alidanda93/RoboBeer/CAO_SolidWorks/3167350_Raspberry_Pi_Camera_V2_Case/images/20181021_031637.jpg

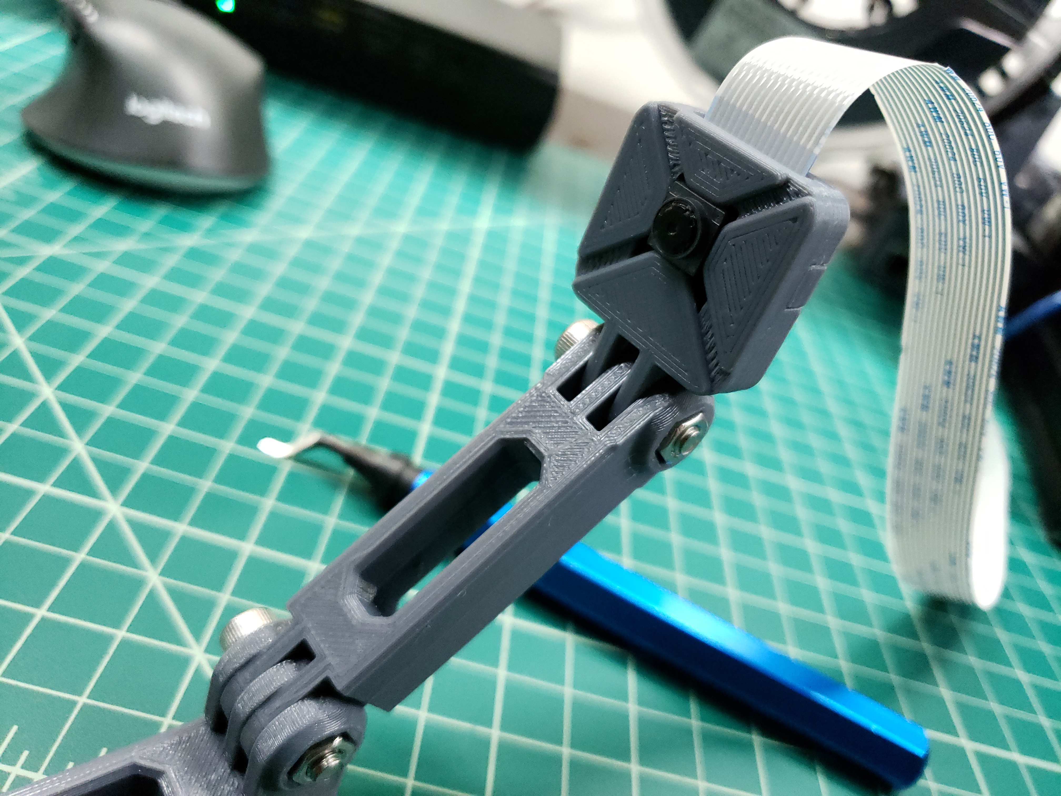
CAO_SolidWorks/3167350_Raspberry_Pi_Camera_V2_Case/images/20181021_031637.jpg
