alidanda93/RoboBeer/README.md

# RoboBeer
Projet de troisième année MSC > ESE
