alidanda93/RoboBeer/STM32/RoboBeer/Doxygene/latex/adc_8c.tex

\hypertarget{adc_8c}{}\doxysection{adc.\+c File Reference}
\label{adc_8c}\index{adc.c@{adc.c}}

This file provides code for the configuration of the ADC instances.  

{\ttfamily \#include \char`\"{}adc.\+h\char`\"{}}\newline
\doxysubsection*{Functions}
\begin{DoxyCompactItemize}
\item 
void \mbox{\hyperlink{adc_8c_acccd58aa70215a6b184ad242312ffd0c}{MX\+\_\+\+ADC1\+\_\+\+Init}} (void)
\item 
void \mbox{\hyperlink{adc_8c_ac3139540667c403c5dfd37a99c610b1c}{HAL\+\_\+\+ADC\+\_\+\+Msp\+Init}} (ADC\+\_\+\+Handle\+Type\+Def $\ast$adc\+Handle)
\item 
void \mbox{\hyperlink{adc_8c_a3f61f2c2af0f122f81a87af8ad7b4360}{HAL\+\_\+\+ADC\+\_\+\+Msp\+De\+Init}} (ADC\+\_\+\+Handle\+Type\+Def $\ast$adc\+Handle)
\end{DoxyCompactItemize}
\doxysubsection*{Variables}
\begin{DoxyCompactItemize}
\item 
\mbox{\Hypertarget{adc_8c_a22b804736f5648d52f639b2647d4ed13}\label{adc_8c_a22b804736f5648d52f639b2647d4ed13}} 
ADC\+\_\+\+Handle\+Type\+Def {\bfseries hadc1}
\end{DoxyCompactItemize}

\doxysubsection{Detailed Description}
This file provides code for the configuration of the ADC instances. 

\begin{DoxyAttention}{Attention}

\end{DoxyAttention}
Copyright (c) 2022 STMicroelectronics. All rights reserved.

This software is licensed under terms that can be found in the LICENSE file in the root directory of this software component. If no LICENSE file comes with this software, it is provided AS-\/\+IS. 

\doxysubsection{Function Documentation}
\mbox{\Hypertarget{adc_8c_a3f61f2c2af0f122f81a87af8ad7b4360}\label{adc_8c_a3f61f2c2af0f122f81a87af8ad7b4360}} 
\index{adc.c@{adc.c}!HAL\_ADC\_MspDeInit@{HAL\_ADC\_MspDeInit}}
\index{HAL\_ADC\_MspDeInit@{HAL\_ADC\_MspDeInit}!adc.c@{adc.c}}
\doxysubsubsection{\texorpdfstring{HAL\_ADC\_MspDeInit()}{HAL\_ADC\_MspDeInit()}}
{\footnotesize\ttfamily void HAL\+\_\+\+ADC\+\_\+\+Msp\+De\+Init (\begin{DoxyParamCaption}\item[{ADC\+\_\+\+Handle\+Type\+Def $\ast$}]{adc\+Handle }\end{DoxyParamCaption})}

ADC1 GPIO Configuration PA4 -\/-\/-\/---\texorpdfstring{$>$}{>} ADC1\+\_\+\+IN4 PA5 -\/-\/-\/---\texorpdfstring{$>$}{>} ADC1\+\_\+\+IN5\mbox{\Hypertarget{adc_8c_ac3139540667c403c5dfd37a99c610b1c}\label{adc_8c_ac3139540667c403c5dfd37a99c610b1c}} 
\index{adc.c@{adc.c}!HAL\_ADC\_MspInit@{HAL\_ADC\_MspInit}}
\index{HAL\_ADC\_MspInit@{HAL\_ADC\_MspInit}!adc.c@{adc.c}}
\doxysubsubsection{\texorpdfstring{HAL\_ADC\_MspInit()}{HAL\_ADC\_MspInit()}}
{\footnotesize\ttfamily void HAL\+\_\+\+ADC\+\_\+\+Msp\+Init (\begin{DoxyParamCaption}\item[{ADC\+\_\+\+Handle\+Type\+Def $\ast$}]{adc\+Handle }\end{DoxyParamCaption})}

ADC1 GPIO Configuration PA4 -\/-\/-\/---\texorpdfstring{$>$}{>} ADC1\+\_\+\+IN4 PA5 -\/-\/-\/---\texorpdfstring{$>$}{>} ADC1\+\_\+\+IN5\mbox{\Hypertarget{adc_8c_acccd58aa70215a6b184ad242312ffd0c}\label{adc_8c_acccd58aa70215a6b184ad242312ffd0c}} 
\index{adc.c@{adc.c}!MX\_ADC1\_Init@{MX\_ADC1\_Init}}
\index{MX\_ADC1\_Init@{MX\_ADC1\_Init}!adc.c@{adc.c}}
\doxysubsubsection{\texorpdfstring{MX\_ADC1\_Init()}{MX\_ADC1\_Init()}}
{\footnotesize\ttfamily void MX\+\_\+\+ADC1\+\_\+\+Init (\begin{DoxyParamCaption}\item[{void}]{ }\end{DoxyParamCaption})}

Common config

Configure Regular Channel
