alidanda93/RoboBeer/STM32/RoboBeer/Doxygene/latex/i2c_8c.tex

\hypertarget{i2c_8c}{}\doxysection{i2c.\+c File Reference}
\label{i2c_8c}\index{i2c.c@{i2c.c}}

This file provides code for the configuration of the I2C instances.  

{\ttfamily \#include \char`\"{}i2c.\+h\char`\"{}}\newline
\doxysubsection*{Functions}
\begin{DoxyCompactItemize}
\item 
\mbox{\Hypertarget{i2c_8c_a021114cd02d4beb0b256095cfbd088b2}\label{i2c_8c_a021114cd02d4beb0b256095cfbd088b2}} 
void {\bfseries MX\+\_\+\+I2\+C2\+\_\+\+Init} (void)
\item 
void \mbox{\hyperlink{i2c_8c_a08b1eb7b7be5b94395127e2a33b1b67e}{HAL\+\_\+\+I2\+C\+\_\+\+Msp\+Init}} (I2\+C\+\_\+\+Handle\+Type\+Def $\ast$i2c\+Handle)
\item 
void \mbox{\hyperlink{i2c_8c_adaa17249f3d5001ad363c736df31c593}{HAL\+\_\+\+I2\+C\+\_\+\+Msp\+De\+Init}} (I2\+C\+\_\+\+Handle\+Type\+Def $\ast$i2c\+Handle)
\end{DoxyCompactItemize}
\doxysubsection*{Variables}
\begin{DoxyCompactItemize}
\item 
\mbox{\Hypertarget{i2c_8c_ac379bcc152d860f08b1279fd3e232295}\label{i2c_8c_ac379bcc152d860f08b1279fd3e232295}} 
I2\+C\+\_\+\+Handle\+Type\+Def {\bfseries hi2c2}
\end{DoxyCompactItemize}

\doxysubsection{Detailed Description}
This file provides code for the configuration of the I2C instances. 

\begin{DoxyAttention}{Attention}

\end{DoxyAttention}
Copyright (c) 2022 STMicroelectronics. All rights reserved.

This software is licensed under terms that can be found in the LICENSE file in the root directory of this software component. If no LICENSE file comes with this software, it is provided AS-\/\+IS. 

\doxysubsection{Function Documentation}
\mbox{\Hypertarget{i2c_8c_adaa17249f3d5001ad363c736df31c593}\label{i2c_8c_adaa17249f3d5001ad363c736df31c593}} 
\index{i2c.c@{i2c.c}!HAL\_I2C\_MspDeInit@{HAL\_I2C\_MspDeInit}}
\index{HAL\_I2C\_MspDeInit@{HAL\_I2C\_MspDeInit}!i2c.c@{i2c.c}}
\doxysubsubsection{\texorpdfstring{HAL\_I2C\_MspDeInit()}{HAL\_I2C\_MspDeInit()}}
{\footnotesize\ttfamily void HAL\+\_\+\+I2\+C\+\_\+\+Msp\+De\+Init (\begin{DoxyParamCaption}\item[{I2\+C\+\_\+\+Handle\+Type\+Def $\ast$}]{i2c\+Handle }\end{DoxyParamCaption})}

I2\+C2 GPIO Configuration PB10 -\/-\/-\/---\texorpdfstring{$>$}{>} I2\+C2\+\_\+\+SCL PB11 -\/-\/-\/---\texorpdfstring{$>$}{>} I2\+C2\+\_\+\+SDA\mbox{\Hypertarget{i2c_8c_a08b1eb7b7be5b94395127e2a33b1b67e}\label{i2c_8c_a08b1eb7b7be5b94395127e2a33b1b67e}} 
\index{i2c.c@{i2c.c}!HAL\_I2C\_MspInit@{HAL\_I2C\_MspInit}}
\index{HAL\_I2C\_MspInit@{HAL\_I2C\_MspInit}!i2c.c@{i2c.c}}
\doxysubsubsection{\texorpdfstring{HAL\_I2C\_MspInit()}{HAL\_I2C\_MspInit()}}
{\footnotesize\ttfamily void HAL\+\_\+\+I2\+C\+\_\+\+Msp\+Init (\begin{DoxyParamCaption}\item[{I2\+C\+\_\+\+Handle\+Type\+Def $\ast$}]{i2c\+Handle }\end{DoxyParamCaption})}

I2\+C2 GPIO Configuration PB10 -\/-\/-\/---\texorpdfstring{$>$}{>} I2\+C2\+\_\+\+SCL PB11 -\/-\/-\/---\texorpdfstring{$>$}{>} I2\+C2\+\_\+\+SDA
