alidanda93/RoboBeer/STM32/RoboBeer/Doxygene/latex/modules.tex

\doxysection{Modules}
Here is a list of all modules\+:\begin{DoxyCompactList}
\item \contentsline{section}{CMSIS}{\pageref{group___c_m_s_i_s}}{}
\begin{DoxyCompactList}
\item \contentsline{section}{Stm32f1xx\+\_\+system}{\pageref{group__stm32f1xx__system}}{}
\begin{DoxyCompactList}
\item \contentsline{section}{STM32\+F1xx\+\_\+\+System\+\_\+\+Private\+\_\+\+Includes}{\pageref{group___s_t_m32_f1xx___system___private___includes}}{}
\item \contentsline{section}{STM32\+F1xx\+\_\+\+System\+\_\+\+Private\+\_\+\+Types\+Definitions}{\pageref{group___s_t_m32_f1xx___system___private___types_definitions}}{}
\item \contentsline{section}{STM32\+F1xx\+\_\+\+System\+\_\+\+Private\+\_\+\+Defines}{\pageref{group___s_t_m32_f1xx___system___private___defines}}{}
\item \contentsline{section}{STM32\+F1xx\+\_\+\+System\+\_\+\+Private\+\_\+\+Macros}{\pageref{group___s_t_m32_f1xx___system___private___macros}}{}
\item \contentsline{section}{STM32\+F1xx\+\_\+\+System\+\_\+\+Private\+\_\+\+Variables}{\pageref{group___s_t_m32_f1xx___system___private___variables}}{}
\item \contentsline{section}{STM32\+F1xx\+\_\+\+System\+\_\+\+Private\+\_\+\+Function\+Prototypes}{\pageref{group___s_t_m32_f1xx___system___private___function_prototypes}}{}
\item \contentsline{section}{STM32\+F1xx\+\_\+\+System\+\_\+\+Private\+\_\+\+Functions}{\pageref{group___s_t_m32_f1xx___system___private___functions}}{}
\end{DoxyCompactList}
\end{DoxyCompactList}
\end{DoxyCompactList}
