alidanda93/RoboBeer/STM32/RoboBeer/Doxygene/latex/stm32f1xx__hal__msp_8c.tex

\hypertarget{stm32f1xx__hal__msp_8c}{}\doxysection{stm32f1xx\+\_\+hal\+\_\+msp.\+c File Reference}
\label{stm32f1xx__hal__msp_8c}\index{stm32f1xx\_hal\_msp.c@{stm32f1xx\_hal\_msp.c}}

This file provides code for the MSP Initialization and de-\/\+Initialization codes.  

{\ttfamily \#include \char`\"{}main.\+h\char`\"{}}\newline
\doxysubsection*{Functions}
\begin{DoxyCompactItemize}
\item 
void \mbox{\hyperlink{stm32f1xx__hal__msp_8c_ae4fb8e66865c87d0ebab74a726a6891f}{HAL\+\_\+\+Msp\+Init}} (void)
\end{DoxyCompactItemize}

\doxysubsection{Detailed Description}
This file provides code for the MSP Initialization and de-\/\+Initialization codes. 

\begin{DoxyAttention}{Attention}

\end{DoxyAttention}
Copyright (c) 2022 STMicroelectronics. All rights reserved.

This software is licensed under terms that can be found in the LICENSE file in the root directory of this software component. If no LICENSE file comes with this software, it is provided AS-\/\+IS. 

\doxysubsection{Function Documentation}
\mbox{\Hypertarget{stm32f1xx__hal__msp_8c_ae4fb8e66865c87d0ebab74a726a6891f}\label{stm32f1xx__hal__msp_8c_ae4fb8e66865c87d0ebab74a726a6891f}} 
\index{stm32f1xx\_hal\_msp.c@{stm32f1xx\_hal\_msp.c}!HAL\_MspInit@{HAL\_MspInit}}
\index{HAL\_MspInit@{HAL\_MspInit}!stm32f1xx\_hal\_msp.c@{stm32f1xx\_hal\_msp.c}}
\doxysubsubsection{\texorpdfstring{HAL\_MspInit()}{HAL\_MspInit()}}
{\footnotesize\ttfamily void HAL\+\_\+\+Msp\+Init (\begin{DoxyParamCaption}\item[{void}]{ }\end{DoxyParamCaption})}

Initializes the Global MSP. NOJTAG\+: JTAG-\/\+DP Disabled and SW-\/\+DP Enabled
