alidanda93/RoboBeer/STM32/RoboBeer/Doxygene/latex/stm32f1xx__it_8c.tex

\hypertarget{stm32f1xx__it_8c}{}\doxysection{stm32f1xx\+\_\+it.\+c File Reference}
\label{stm32f1xx__it_8c}\index{stm32f1xx\_it.c@{stm32f1xx\_it.c}}

Interrupt Service Routines.  

{\ttfamily \#include \char`\"{}main.\+h\char`\"{}}\newline
{\ttfamily \#include \char`\"{}stm32f1xx\+\_\+it.\+h\char`\"{}}\newline
\doxysubsection*{Functions}
\begin{DoxyCompactItemize}
\item 
\mbox{\Hypertarget{stm32f1xx__it_8c_a6ad7a5e3ee69cb6db6a6b9111ba898bc}\label{stm32f1xx__it_8c_a6ad7a5e3ee69cb6db6a6b9111ba898bc}} 
void {\bfseries NMI\+\_\+\+Handler} (void)
\begin{DoxyCompactList}\small\item\em This function handles Non maskable interrupt. \end{DoxyCompactList}\item 
\mbox{\Hypertarget{stm32f1xx__it_8c_a2bffc10d5bd4106753b7c30e86903bea}\label{stm32f1xx__it_8c_a2bffc10d5bd4106753b7c30e86903bea}} 
void {\bfseries Hard\+Fault\+\_\+\+Handler} (void)
\begin{DoxyCompactList}\small\item\em This function handles Hard fault interrupt. \end{DoxyCompactList}\item 
\mbox{\Hypertarget{stm32f1xx__it_8c_a3150f74512510287a942624aa9b44cc5}\label{stm32f1xx__it_8c_a3150f74512510287a942624aa9b44cc5}} 
void {\bfseries Mem\+Manage\+\_\+\+Handler} (void)
\begin{DoxyCompactList}\small\item\em This function handles Memory management fault. \end{DoxyCompactList}\item 
\mbox{\Hypertarget{stm32f1xx__it_8c_a850cefb17a977292ae5eb4cafa9976c3}\label{stm32f1xx__it_8c_a850cefb17a977292ae5eb4cafa9976c3}} 
void {\bfseries Bus\+Fault\+\_\+\+Handler} (void)
\begin{DoxyCompactList}\small\item\em This function handles Prefetch fault, memory access fault. \end{DoxyCompactList}\item 
\mbox{\Hypertarget{stm32f1xx__it_8c_a1d98923de2ed6b7309b66f9ba2971647}\label{stm32f1xx__it_8c_a1d98923de2ed6b7309b66f9ba2971647}} 
void {\bfseries Usage\+Fault\+\_\+\+Handler} (void)
\begin{DoxyCompactList}\small\item\em This function handles Undefined instruction or illegal state. \end{DoxyCompactList}\item 
\mbox{\Hypertarget{stm32f1xx__it_8c_a3e5ddb3df0d62f2dc357e64a3f04a6ce}\label{stm32f1xx__it_8c_a3e5ddb3df0d62f2dc357e64a3f04a6ce}} 
void {\bfseries SVC\+\_\+\+Handler} (void)
\begin{DoxyCompactList}\small\item\em This function handles System service call via SWI instruction. \end{DoxyCompactList}\item 
\mbox{\Hypertarget{stm32f1xx__it_8c_adbdfb05858cc36fc520974df37ec3cb0}\label{stm32f1xx__it_8c_adbdfb05858cc36fc520974df37ec3cb0}} 
void {\bfseries Debug\+Mon\+\_\+\+Handler} (void)
\begin{DoxyCompactList}\small\item\em This function handles Debug monitor. \end{DoxyCompactList}\item 
\mbox{\Hypertarget{stm32f1xx__it_8c_a6303e1f258cbdc1f970ce579cc015623}\label{stm32f1xx__it_8c_a6303e1f258cbdc1f970ce579cc015623}} 
void {\bfseries Pend\+SV\+\_\+\+Handler} (void)
\begin{DoxyCompactList}\small\item\em This function handles Pendable request for system service. \end{DoxyCompactList}\item 
\mbox{\Hypertarget{stm32f1xx__it_8c_ab5e09814056d617c521549e542639b7e}\label{stm32f1xx__it_8c_ab5e09814056d617c521549e542639b7e}} 
void {\bfseries Sys\+Tick\+\_\+\+Handler} (void)
\begin{DoxyCompactList}\small\item\em This function handles System tick timer. \end{DoxyCompactList}\item 
\mbox{\Hypertarget{stm32f1xx__it_8c_a17e9789a29a87d2df54f12b94dd1a0b6}\label{stm32f1xx__it_8c_a17e9789a29a87d2df54f12b94dd1a0b6}} 
void {\bfseries EXTI0\+\_\+\+IRQHandler} (void)
\begin{DoxyCompactList}\small\item\em This function handles EXTI line0 interrupt. \end{DoxyCompactList}\item 
\mbox{\Hypertarget{stm32f1xx__it_8c_a49cfdd46eb8d0ef3e1987514aa9343dc}\label{stm32f1xx__it_8c_a49cfdd46eb8d0ef3e1987514aa9343dc}} 
void {\bfseries EXTI1\+\_\+\+IRQHandler} (void)
\begin{DoxyCompactList}\small\item\em This function handles EXTI line1 interrupt. \end{DoxyCompactList}\item 
\mbox{\Hypertarget{stm32f1xx__it_8c_a290cb997018c8d85d4b965b4a242842f}\label{stm32f1xx__it_8c_a290cb997018c8d85d4b965b4a242842f}} 
void {\bfseries EXTI4\+\_\+\+IRQHandler} (void)
\begin{DoxyCompactList}\small\item\em This function handles EXTI line4 interrupt. \end{DoxyCompactList}\item 
\mbox{\Hypertarget{stm32f1xx__it_8c_ab74311855aee10304ffc57c319c91ed3}\label{stm32f1xx__it_8c_ab74311855aee10304ffc57c319c91ed3}} 
void {\bfseries DMA1\+\_\+\+Channel6\+\_\+\+IRQHandler} (void)
\begin{DoxyCompactList}\small\item\em This function handles DMA1 channel6 global interrupt. \end{DoxyCompactList}\item 
\mbox{\Hypertarget{stm32f1xx__it_8c_a7b2096b8b2643286dc3a7e5110e5ae85}\label{stm32f1xx__it_8c_a7b2096b8b2643286dc3a7e5110e5ae85}} 
void {\bfseries EXTI9\+\_\+5\+\_\+\+IRQHandler} (void)
\begin{DoxyCompactList}\small\item\em This function handles EXTI line\mbox{[}9\+:5\mbox{]} interrupts. \end{DoxyCompactList}\item 
\mbox{\Hypertarget{stm32f1xx__it_8c_a51741dbf9b0de1b8b56b5a6f1ef2e694}\label{stm32f1xx__it_8c_a51741dbf9b0de1b8b56b5a6f1ef2e694}} 
void {\bfseries TIM1\+\_\+\+UP\+\_\+\+IRQHandler} (void)
\begin{DoxyCompactList}\small\item\em This function handles TIM1 update interrupt. \end{DoxyCompactList}\item 
\mbox{\Hypertarget{stm32f1xx__it_8c_a38ad4725462bdc5e86c4ead4f04b9fc2}\label{stm32f1xx__it_8c_a38ad4725462bdc5e86c4ead4f04b9fc2}} 
void {\bfseries TIM2\+\_\+\+IRQHandler} (void)
\begin{DoxyCompactList}\small\item\em This function handles TIM2 global interrupt. \end{DoxyCompactList}\item 
\mbox{\Hypertarget{stm32f1xx__it_8c_ac8e51d2183b5230cbd5481f8867adce9}\label{stm32f1xx__it_8c_ac8e51d2183b5230cbd5481f8867adce9}} 
void {\bfseries TIM3\+\_\+\+IRQHandler} (void)
\begin{DoxyCompactList}\small\item\em This function handles TIM3 global interrupt. \end{DoxyCompactList}\item 
\mbox{\Hypertarget{stm32f1xx__it_8c_a7133f3f78767503641d307386e68bd28}\label{stm32f1xx__it_8c_a7133f3f78767503641d307386e68bd28}} 
void {\bfseries TIM4\+\_\+\+IRQHandler} (void)
\begin{DoxyCompactList}\small\item\em This function handles TIM4 global interrupt. \end{DoxyCompactList}\item 
\mbox{\Hypertarget{stm32f1xx__it_8c_a7139cd4baabbbcbab0c1fe6d7d4ae1cc}\label{stm32f1xx__it_8c_a7139cd4baabbbcbab0c1fe6d7d4ae1cc}} 
void {\bfseries USART1\+\_\+\+IRQHandler} (void)
\begin{DoxyCompactList}\small\item\em This function handles USART1 global interrupt. \end{DoxyCompactList}\item 
\mbox{\Hypertarget{stm32f1xx__it_8c_a0ca6fd0e6f77921dd1123539857ba0a8}\label{stm32f1xx__it_8c_a0ca6fd0e6f77921dd1123539857ba0a8}} 
void {\bfseries USART2\+\_\+\+IRQHandler} (void)
\begin{DoxyCompactList}\small\item\em This function handles USART2 global interrupt. \end{DoxyCompactList}\item 
\mbox{\Hypertarget{stm32f1xx__it_8c_a738473a5b43f6c92b80ce1d3d6f77ed9}\label{stm32f1xx__it_8c_a738473a5b43f6c92b80ce1d3d6f77ed9}} 
void {\bfseries EXTI15\+\_\+10\+\_\+\+IRQHandler} (void)
\begin{DoxyCompactList}\small\item\em This function handles EXTI line\mbox{[}15\+:10\mbox{]} interrupts. \end{DoxyCompactList}\item 
\mbox{\Hypertarget{stm32f1xx__it_8c_a5e66446caf21dd90191dc07a13ce2378}\label{stm32f1xx__it_8c_a5e66446caf21dd90191dc07a13ce2378}} 
void {\bfseries TIM5\+\_\+\+IRQHandler} (void)
\begin{DoxyCompactList}\small\item\em This function handles TIM5 global interrupt. \end{DoxyCompactList}\item 
\mbox{\Hypertarget{stm32f1xx__it_8c_a0453d4621224d4aed7b6f727f12657b2}\label{stm32f1xx__it_8c_a0453d4621224d4aed7b6f727f12657b2}} 
void {\bfseries TIM6\+\_\+\+IRQHandler} (void)
\begin{DoxyCompactList}\small\item\em This function handles TIM6 global interrupt. \end{DoxyCompactList}\item 
\mbox{\Hypertarget{stm32f1xx__it_8c_a98cff83252098363b2dbca9608df964e}\label{stm32f1xx__it_8c_a98cff83252098363b2dbca9608df964e}} 
void {\bfseries TIM7\+\_\+\+IRQHandler} (void)
\begin{DoxyCompactList}\small\item\em This function handles TIM7 global interrupt. \end{DoxyCompactList}\end{DoxyCompactItemize}
\doxysubsection*{Variables}
\begin{DoxyCompactItemize}
\item 
\mbox{\Hypertarget{stm32f1xx__it_8c_a25fc663547539bc49fecc0011bd76ab5}\label{stm32f1xx__it_8c_a25fc663547539bc49fecc0011bd76ab5}} 
TIM\+\_\+\+Handle\+Type\+Def {\bfseries htim1}
\item 
\mbox{\Hypertarget{stm32f1xx__it_8c_a2c80fd5510e2990a59a5c90d745c716c}\label{stm32f1xx__it_8c_a2c80fd5510e2990a59a5c90d745c716c}} 
TIM\+\_\+\+Handle\+Type\+Def {\bfseries htim2}
\item 
\mbox{\Hypertarget{stm32f1xx__it_8c_aac3d2c59ee0e3bbae1b99529a154eb62}\label{stm32f1xx__it_8c_aac3d2c59ee0e3bbae1b99529a154eb62}} 
TIM\+\_\+\+Handle\+Type\+Def {\bfseries htim3}
\item 
\mbox{\Hypertarget{stm32f1xx__it_8c_a85788cec5a97ee377e4ee2e74f026484}\label{stm32f1xx__it_8c_a85788cec5a97ee377e4ee2e74f026484}} 
TIM\+\_\+\+Handle\+Type\+Def {\bfseries htim4}
\item 
\mbox{\Hypertarget{stm32f1xx__it_8c_acefaeaaa3856ddddae7083b2d220fe4b}\label{stm32f1xx__it_8c_acefaeaaa3856ddddae7083b2d220fe4b}} 
TIM\+\_\+\+Handle\+Type\+Def {\bfseries htim5}
\item 
\mbox{\Hypertarget{stm32f1xx__it_8c_a1564492831a79fa18466467c3420c3c3}\label{stm32f1xx__it_8c_a1564492831a79fa18466467c3420c3c3}} 
TIM\+\_\+\+Handle\+Type\+Def {\bfseries htim6}
\item 
\mbox{\Hypertarget{stm32f1xx__it_8c_abb71bf3ee68e2a051fbeec6c3ab3012d}\label{stm32f1xx__it_8c_abb71bf3ee68e2a051fbeec6c3ab3012d}} 
TIM\+\_\+\+Handle\+Type\+Def {\bfseries htim7}
\item 
\mbox{\Hypertarget{stm32f1xx__it_8c_a784aa25dc7e4580cfbf80658340f482c}\label{stm32f1xx__it_8c_a784aa25dc7e4580cfbf80658340f482c}} 
DMA\+\_\+\+Handle\+Type\+Def {\bfseries hdma\+\_\+usart2\+\_\+rx}
\item 
\mbox{\Hypertarget{stm32f1xx__it_8c_a2cf715bef37f7e8ef385a30974a5f0d5}\label{stm32f1xx__it_8c_a2cf715bef37f7e8ef385a30974a5f0d5}} 
UART\+\_\+\+Handle\+Type\+Def {\bfseries huart1}
\item 
\mbox{\Hypertarget{stm32f1xx__it_8c_aa9479c261d65eecedd3d9582f7f0f89c}\label{stm32f1xx__it_8c_aa9479c261d65eecedd3d9582f7f0f89c}} 
UART\+\_\+\+Handle\+Type\+Def {\bfseries huart2}
\end{DoxyCompactItemize}

\doxysubsection{Detailed Description}
Interrupt Service Routines. 

\begin{DoxyAttention}{Attention}

\end{DoxyAttention}
Copyright (c) 2022 STMicroelectronics. All rights reserved.

This software is licensed under terms that can be found in the LICENSE file in the root directory of this software component. If no LICENSE file comes with this software, it is provided AS-\/\+IS.
