alidanda93/RoboBeer/STM32/RoboBeer/Doxygene/latex/system__stm32f1xx_8c.tex

\hypertarget{system__stm32f1xx_8c}{}\doxysection{system\+\_\+stm32f1xx.\+c File Reference}
\label{system__stm32f1xx_8c}\index{system\_stm32f1xx.c@{system\_stm32f1xx.c}}

CMSIS Cortex-\/\+M3 Device Peripheral Access Layer System Source File.  

{\ttfamily \#include \char`\"{}stm32f1xx.\+h\char`\"{}}\newline
\doxysubsection*{Macros}
\begin{DoxyCompactItemize}
\item 
\#define \mbox{\hyperlink{group___s_t_m32_f1xx___system___private___defines_gaeafcff4f57440c60e64812dddd13e7cb}{HSE\+\_\+\+VALUE}}~8000000U
\item 
\#define \mbox{\hyperlink{group___s_t_m32_f1xx___system___private___defines_gaaa8c76e274d0f6dd2cefb5d0b17fbc37}{HSI\+\_\+\+VALUE}}~8000000U
\end{DoxyCompactItemize}
\doxysubsection*{Functions}
\begin{DoxyCompactItemize}
\item 
void \mbox{\hyperlink{group___s_t_m32_f1xx___system___private___functions_ga93f514700ccf00d08dbdcff7f1224eb2}{System\+Init}} (void)
\begin{DoxyCompactList}\small\item\em Setup the microcontroller system Initialize the Embedded Flash Interface, the PLL and update the System\+Core\+Clock variable. \end{DoxyCompactList}\item 
void \mbox{\hyperlink{group___s_t_m32_f1xx___system___private___functions_gae0c36a9591fe6e9c45ecb21a794f0f0f}{System\+Core\+Clock\+Update}} (void)
\begin{DoxyCompactList}\small\item\em Update System\+Core\+Clock variable according to Clock Register Values. The System\+Core\+Clock variable contains the core clock (HCLK), it can be used by the user application to setup the Sys\+Tick timer or configure other parameters. \end{DoxyCompactList}\end{DoxyCompactItemize}
\doxysubsection*{Variables}
\begin{DoxyCompactItemize}
\item 
uint32\+\_\+t {\bfseries System\+Core\+Clock} = 16000000
\item 
const uint8\+\_\+t {\bfseries AHBPresc\+Table} \mbox{[}16U\mbox{]} = \{0, 0, 0, 0, 0, 0, 0, 0, 1, 2, 3, 4, 6, 7, 8, 9\}
\item 
const uint8\+\_\+t {\bfseries APBPresc\+Table} \mbox{[}8U\mbox{]} = \{0, 0, 0, 0, 1, 2, 3, 4\}
\end{DoxyCompactItemize}

\doxysubsection{Detailed Description}
CMSIS Cortex-\/\+M3 Device Peripheral Access Layer System Source File. 

\begin{DoxyAuthor}{Author}
MCD Application Team 
\end{DoxyAuthor}

\begin{DoxyEnumerate}
\item This file provides two functions and one global variable to be called from user application\+:
\begin{DoxyItemize}
\item \mbox{\hyperlink{group___s_t_m32_f1xx___system___private___functions_ga93f514700ccf00d08dbdcff7f1224eb2}{System\+Init()}}\+: Setups the system clock (System clock source, PLL Multiplier factors, AHB/\+APBx prescalers and Flash settings). This function is called at startup just after reset and before branch to main program. This call is made inside the \char`\"{}startup\+\_\+stm32f1xx\+\_\+xx.\+s\char`\"{} file.
\item System\+Core\+Clock variable\+: Contains the core clock (HCLK), it can be used by the user application to setup the Sys\+Tick timer or configure other parameters.
\item \mbox{\hyperlink{group___s_t_m32_f1xx___system___private___functions_gae0c36a9591fe6e9c45ecb21a794f0f0f}{System\+Core\+Clock\+Update()}}\+: Updates the variable System\+Core\+Clock and must be called whenever the core clock is changed during program execution.
\end{DoxyItemize}
\item After each device reset the HSI (8 MHz) is used as system clock source. Then \mbox{\hyperlink{group___s_t_m32_f1xx___system___private___functions_ga93f514700ccf00d08dbdcff7f1224eb2}{System\+Init()}} function is called, in \char`\"{}startup\+\_\+stm32f1xx\+\_\+xx.\+s\char`\"{} file, to configure the system clock before to branch to main program.
\item The default value of HSE crystal is set to 8 MHz (or 25 MHz, depending on the product used), refer to \char`\"{}\+HSE\+\_\+\+VALUE\char`\"{}. When HSE is used as system clock source, directly or through PLL, and you are using different crystal you have to adapt the HSE value to your own configuration.
\end{DoxyEnumerate}

\begin{DoxyAttention}{Attention}

\end{DoxyAttention}
\doxysubsubsection*{\begin{center}\copyright{} Copyright (c) 2017 STMicroelectronics. All rights reserved.\end{center} }

This software component is licensed by ST under BSD 3-\/Clause license, the \char`\"{}\+License\char`\"{}; You may not use this file except in compliance with the License. You may obtain a copy of the License at\+: opensource.\+org/licenses/\+BSD-\/3-\/\+Clause
