alidanda93/RoboBeer/CAO_SolidWorks/3167350_Raspberry_Pi_Camera_V2_Case/images/4.PNG

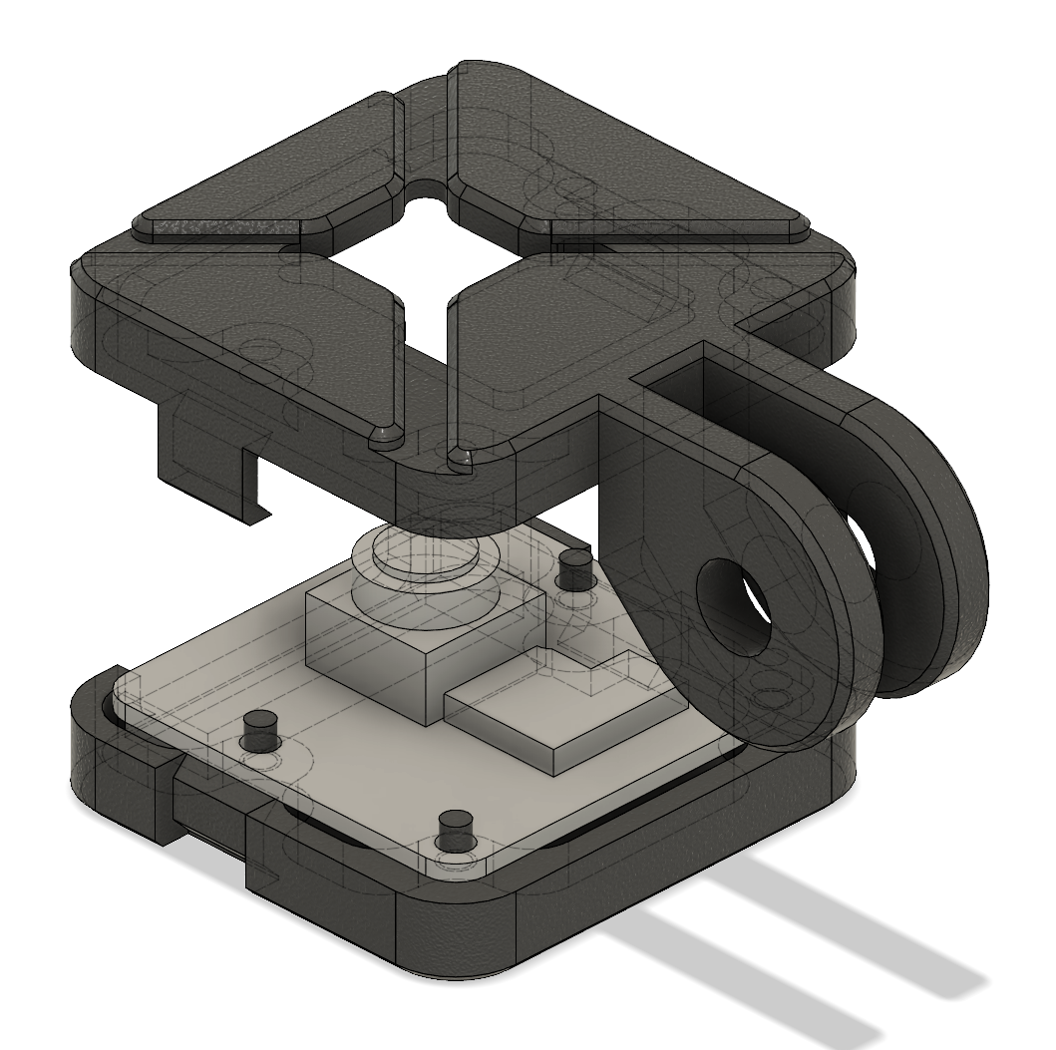
CAO_SolidWorks/3167350_Raspberry_Pi_Camera_V2_Case/images/4.PNG
