alidanda93/RoboBeer/CAO_SolidWorks/3167350_Raspberry_Pi_Camera_V2_Case/images/Face.png

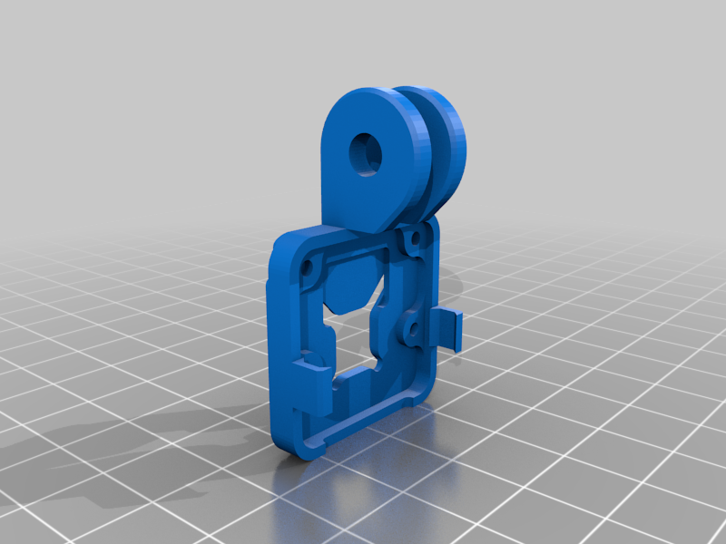
CAO_SolidWorks/3167350_Raspberry_Pi_Camera_V2_Case/images/Face.png
