alidanda93/RoboBeer/CAO_SolidWorks/Snapshot/base roulante 2.png

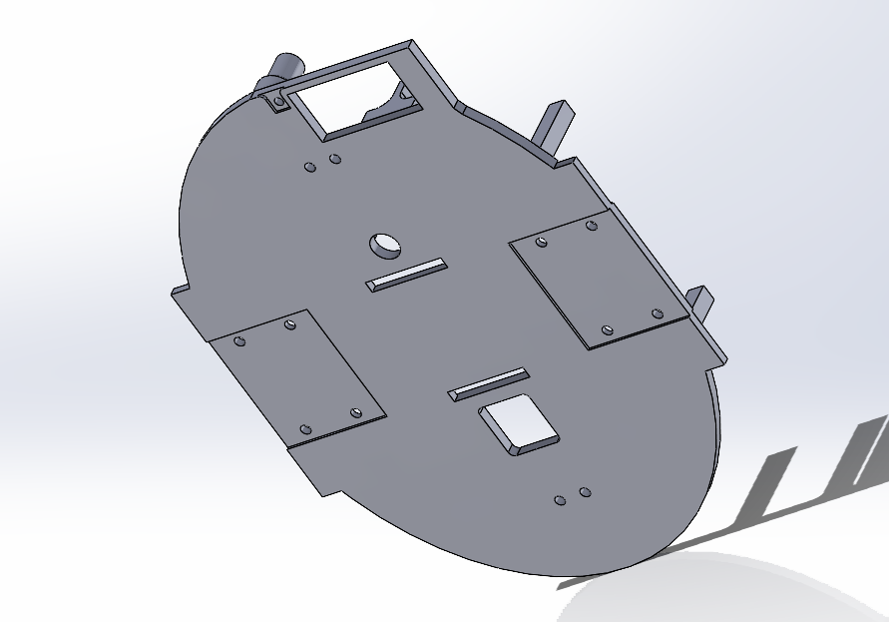
CAO_SolidWorks/Snapshot/base roulante 2.png
