alidanda93/RoboBeer/CAO_SolidWorks/Snapshot/base roulante.png

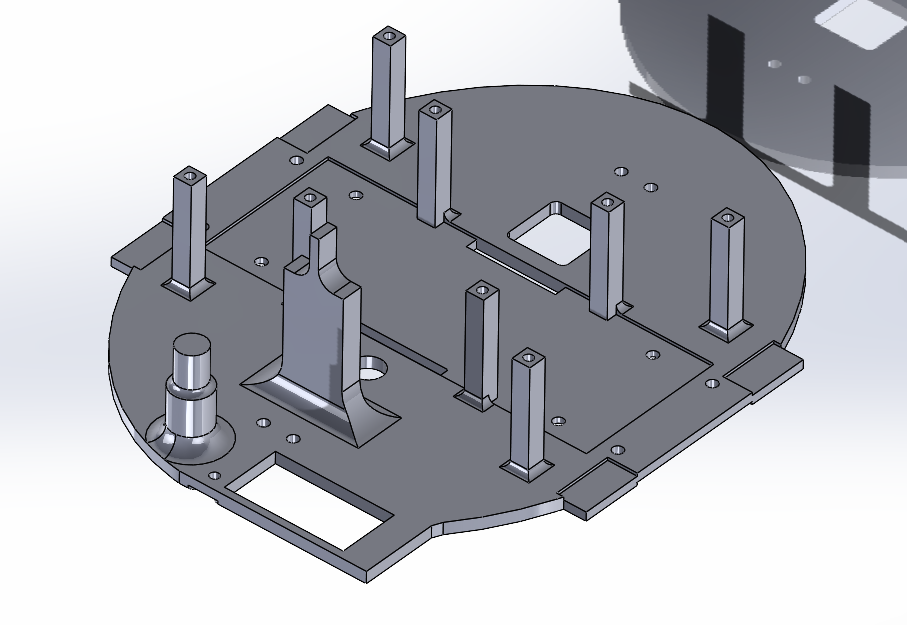
CAO_SolidWorks/Snapshot/base roulante.png
