alidanda93/RoboBeer/CAO_SolidWorks/Snapshot/dimensions Pi4.png

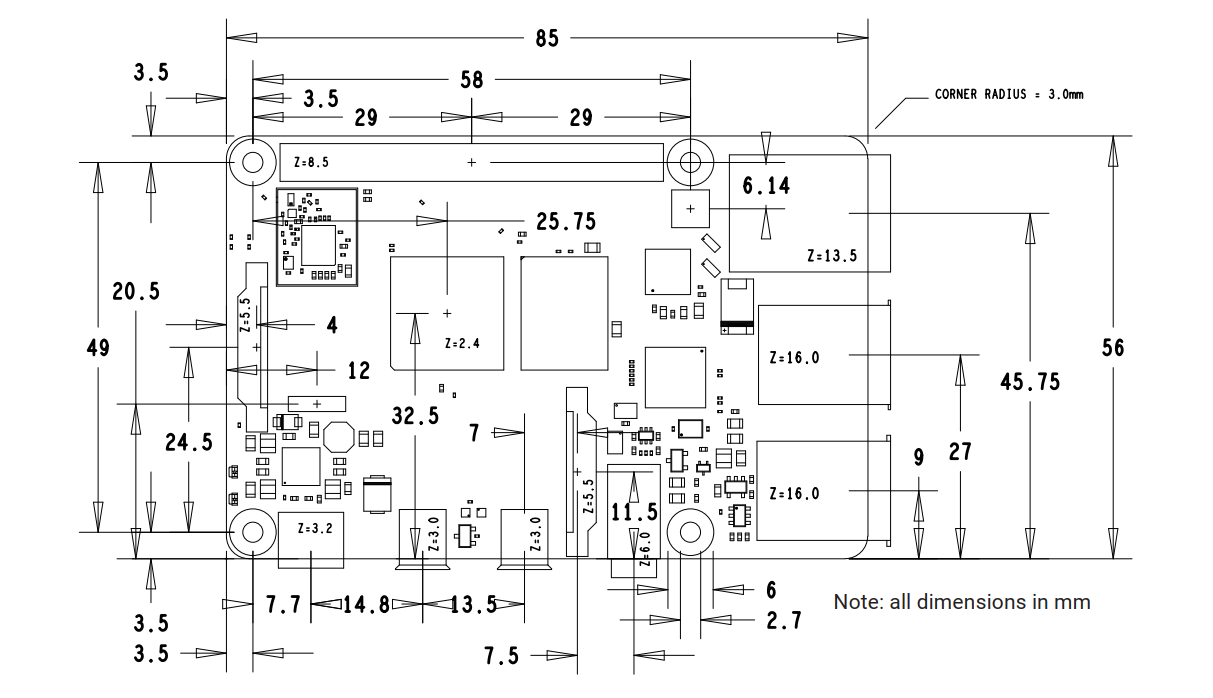
CAO_SolidWorks/Snapshot/dimensions Pi4.png
