alidanda93/RoboBeer/CAO_SolidWorks/Snapshot/ensemble robot 2.png

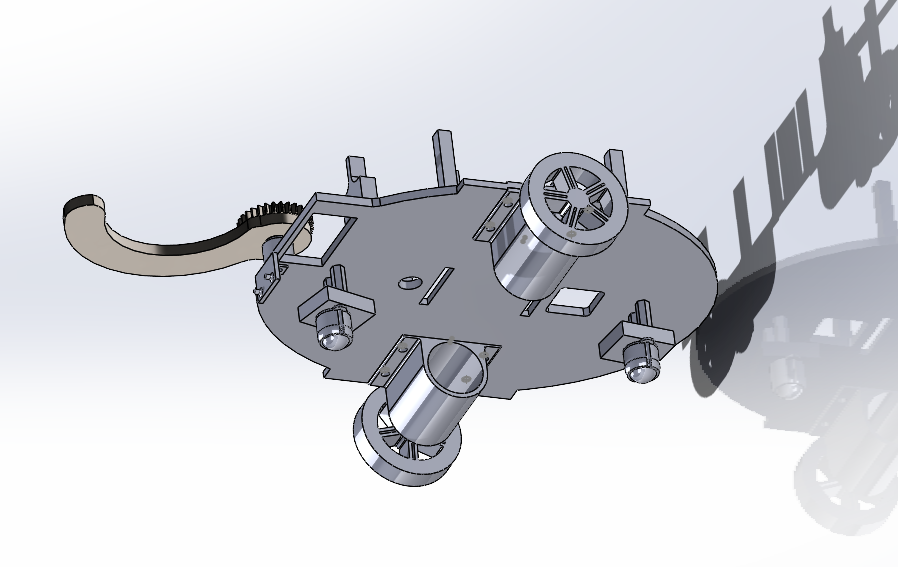
CAO_SolidWorks/Snapshot/ensemble robot 2.png
