alidanda93/RoboBeer/CAO_SolidWorks/Snapshot/ensemble robot.png

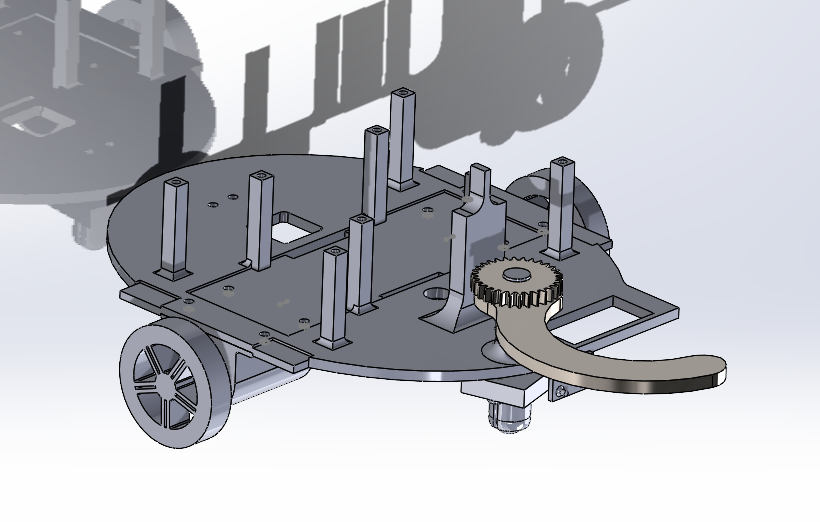
CAO_SolidWorks/Snapshot/ensemble robot.png
