alidanda93/RoboBeer/CAO_SolidWorks/Snapshot/GMP.png

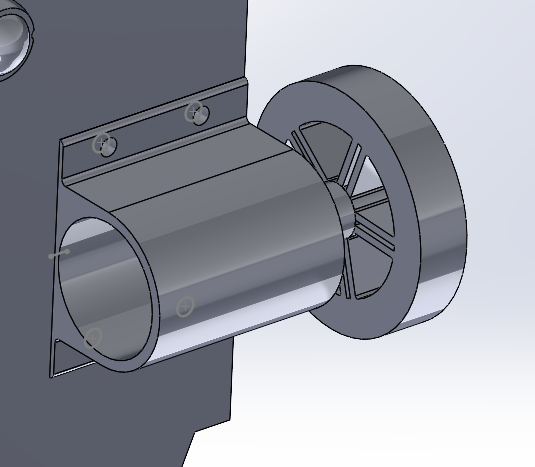
CAO_SolidWorks/Snapshot/GMP.png
