alidanda93/RoboBeer/CAO_SolidWorks/Snapshot/pince+tof.png

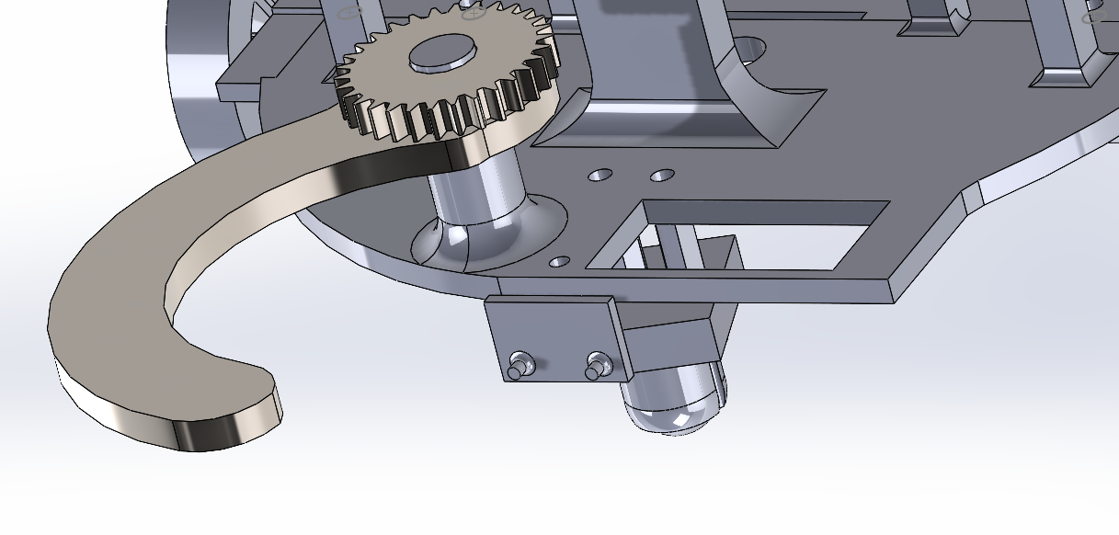
CAO_SolidWorks/Snapshot/pince+tof.png
