alidanda93/RoboBeer/CAO_SolidWorks/AssemblageBoitierCarteMere.SLDASM

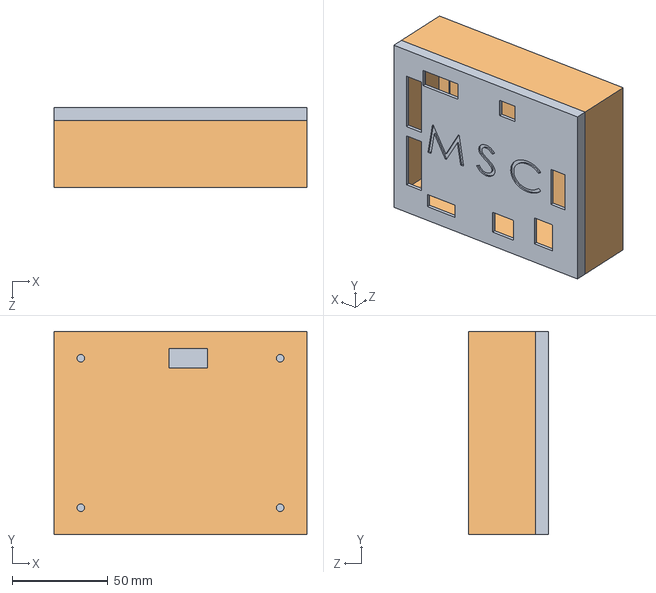
[picture p50: CAD file, 2023-01-16]
CAO_SolidWorks/AssemblageBoitierCarteMere.SLDASM
132.0 x 106.0 x 42.0 mm
couvercleCarteMere
SupportCarteMere
