alidanda93/RoboBeer/CAO_SolidWorks/roue folle 0.5pouce/roue folle.SLDASM

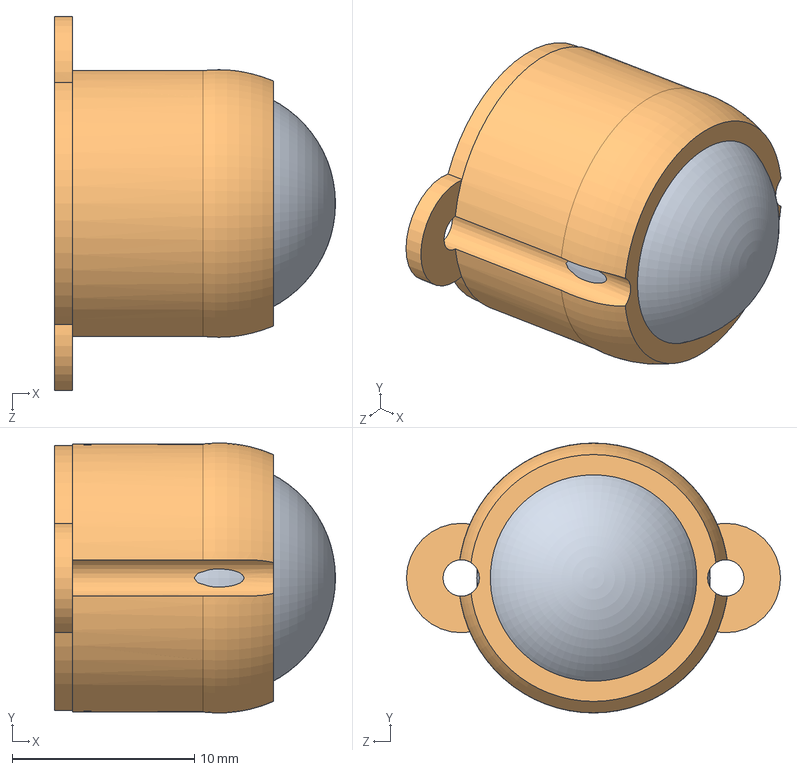
[picture p51: CAD file, 2023-01-13]
CAO_SolidWorks/roue folle 0.5pouce/roue folle.SLDASM
15.4 x 14.8 x 20.5 mm
bille
support
