alidanda93/RoboBeer/CAO_SolidWorks/Pince/Assemblage1.SLDASM

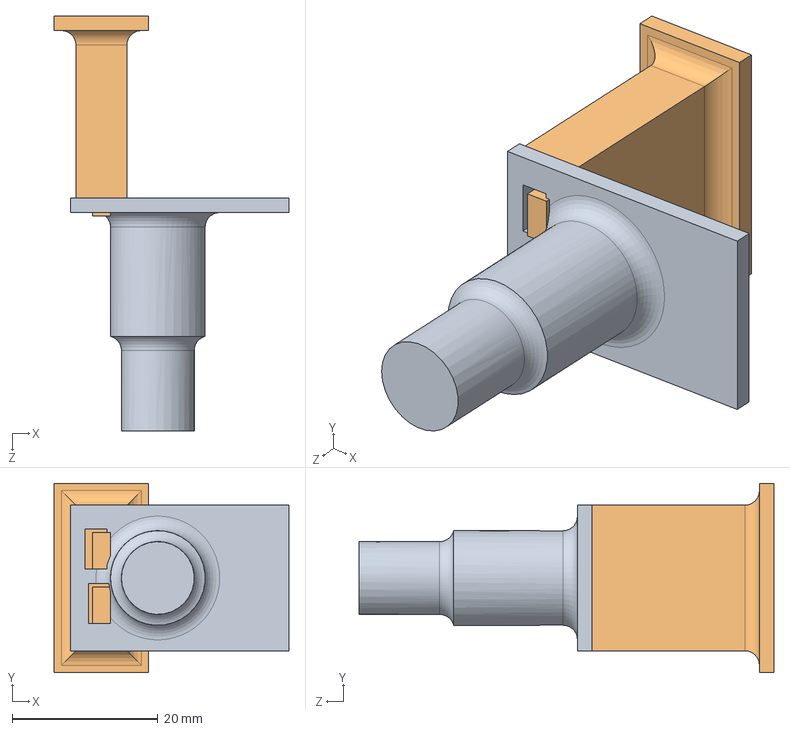
[picture p52: CAD file, 2023-01-13]
CAO_SolidWorks/Pince/Assemblage1.SLDASM
32.2 x 26.0 x 57.0 mm
Supportv2_1
Supportv2_2
