alidanda93/RoboBeer/CAO_SolidWorks/Pince/Assemblage.SLDASM

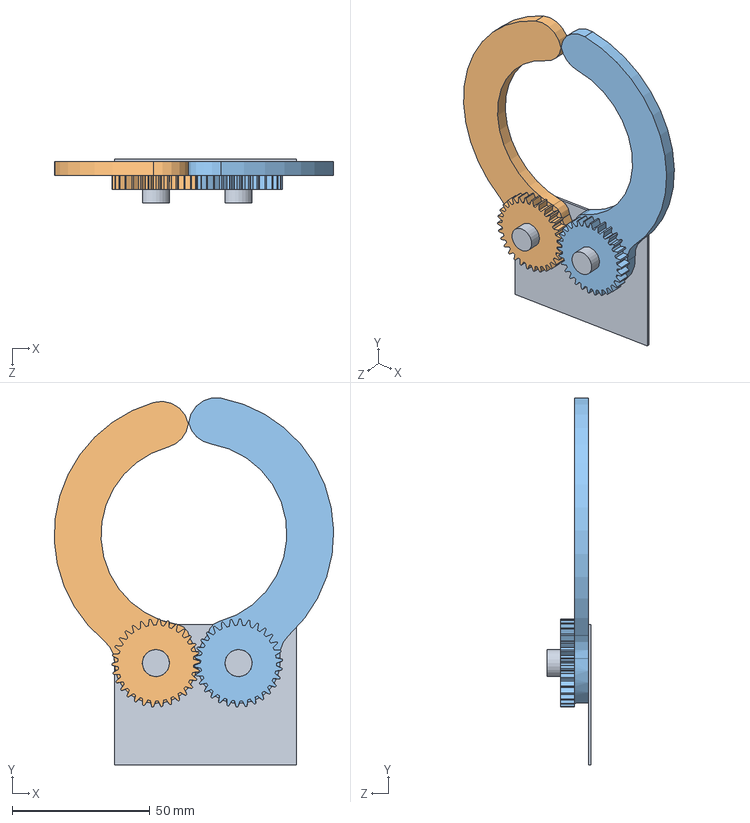
[picture p53: CAD file, 2023-01-13]
CAO_SolidWorks/Pince/Assemblage.SLDASM
101.4 x 133.2 x 16.0 mm
Support Pince
engrenage1
engrenage2
