alidanda93/RoboBeer/CAO_SolidWorks/Assemblage_Base_roulante.SLDASM

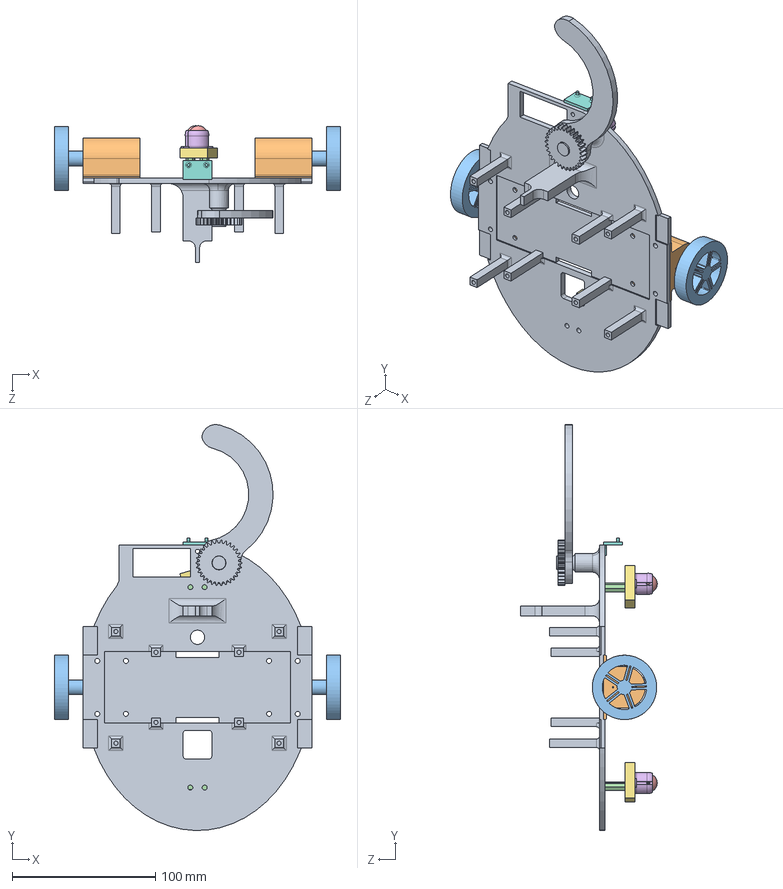
[picture p54: CAD file, 2023-01-13]
CAO_SolidWorks/Assemblage_Base_roulante.SLDASM
200.0 x 283.6 x 95.4 mm
Base rolante
support_moteur_v2 x 2
roue_v2 x 2
entretoise x 4
bille x 2
support x 2
rouefolle x 2
TOF
engrenage2
