alidanda93/RoboBeer/CAO_SolidWorks/3167350_Raspberry_Pi_Camera_V2_Case/files/Back.stl

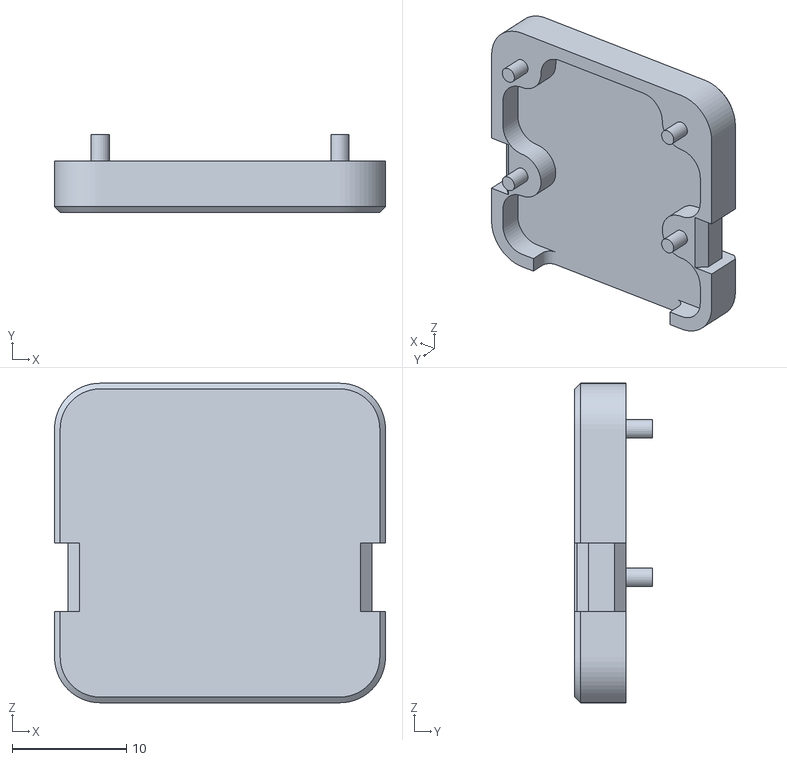
[picture p55: CAD file, 2023-01-13]
CAO_SolidWorks/3167350_Raspberry_Pi_Camera_V2_Case/files/Back.stl
29.0 x 6.80 x 28.0
