alidanda93/RoboBeer/CAO_SolidWorks/BDT.SLDPRT

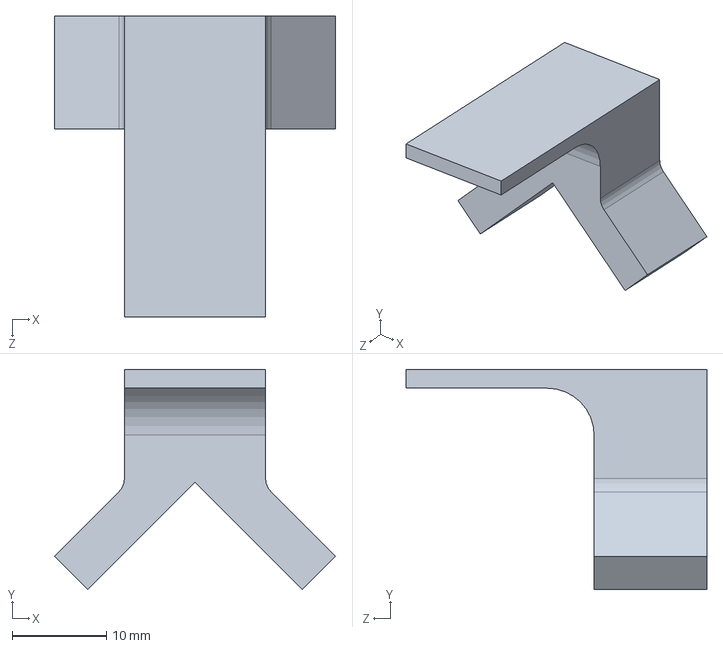
[picture p56: CAD file, 2023-01-19]
CAO_SolidWorks/BDT.SLDPRT
29.9 x 23.4 x 32.0 mm
