alidanda93/RoboBeer/CAO_SolidWorks/Pince/Supportv2_1.SLDPRT

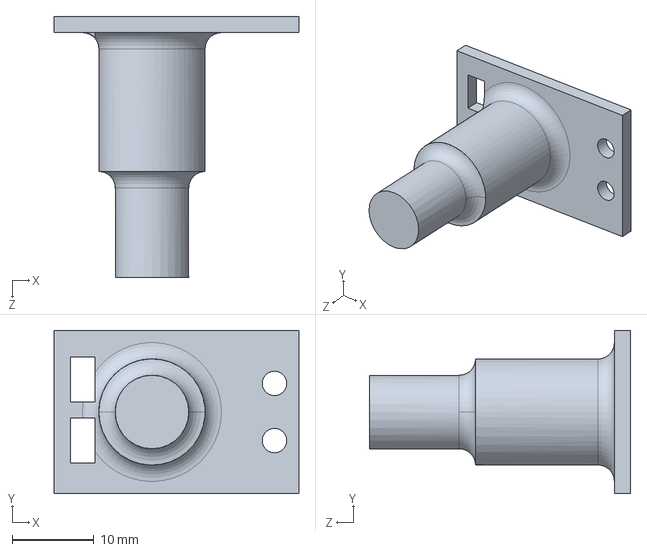
[picture p57: CAD file, 2023-01-13]
CAO_SolidWorks/Pince/Supportv2_1.SLDPRT
30.0 x 20.0 x 32.0 mm
