alidanda93/RoboBeer/CAO_SolidWorks/roue folle 0.5pouce/support.SLDPRT

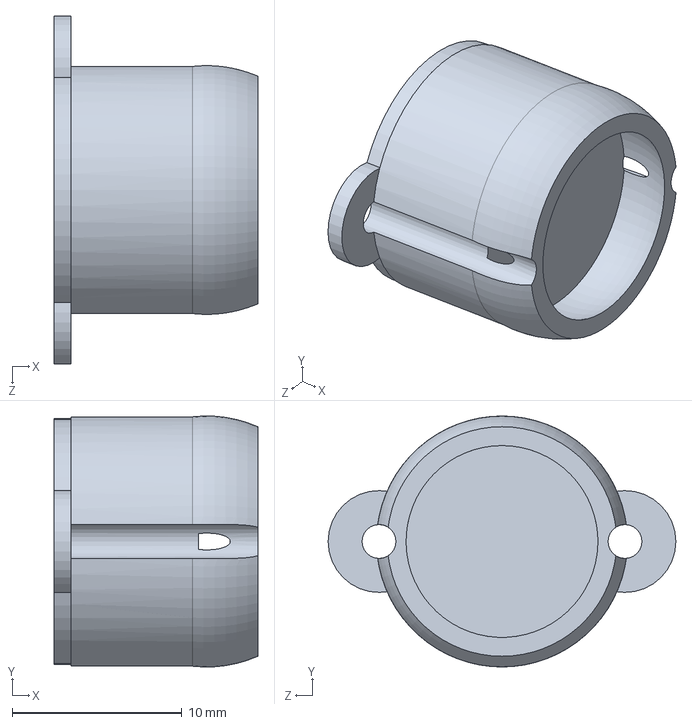
[picture p58: CAD file, 2023-01-13]
CAO_SolidWorks/roue folle 0.5pouce/support.SLDPRT
12.0 x 14.8 x 20.5 mm
