alidanda93/RoboBeer/CAO_SolidWorks/STL/support_moteur_v3.STL

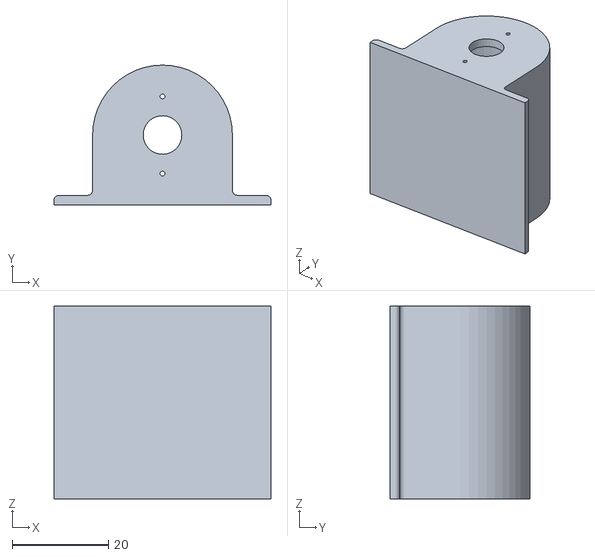
[picture p59: CAD file, 2023-01-13]
CAO_SolidWorks/STL/support_moteur_v3.STL
45.0 x 29.0 x 40.0
