alidanda93/RoboBeer/CAO_SolidWorks/3167350_Raspberry_Pi_Camera_V2_Case/files/Face.stl

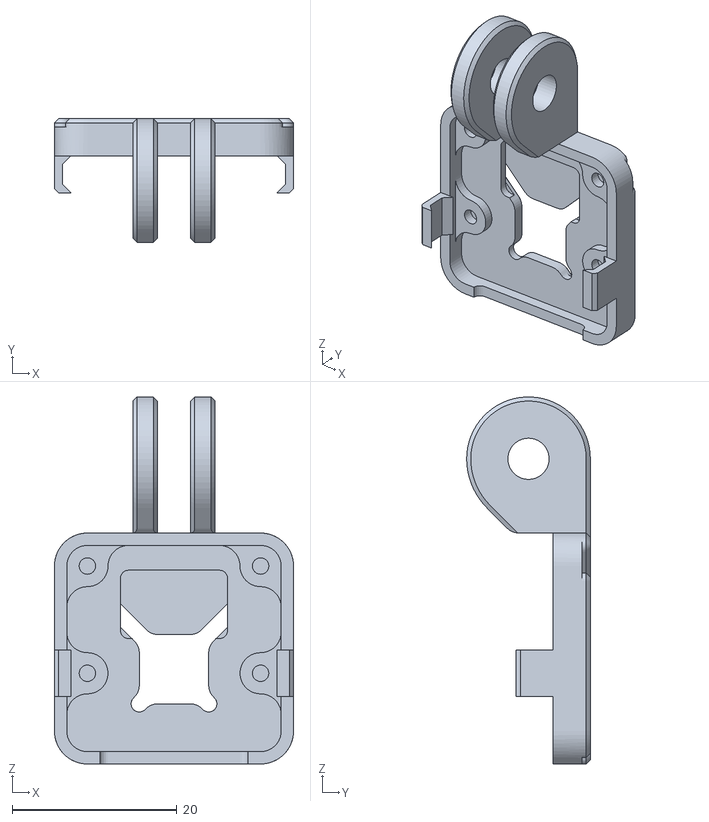
[picture p60: CAD file, 2023-01-13]
CAO_SolidWorks/3167350_Raspberry_Pi_Camera_V2_Case/files/Face.stl
29.0 x 15.0 x 44.5
