alidanda93/RoboBeer/CAO_SolidWorks/Pince/engrenage1.SLDPRT

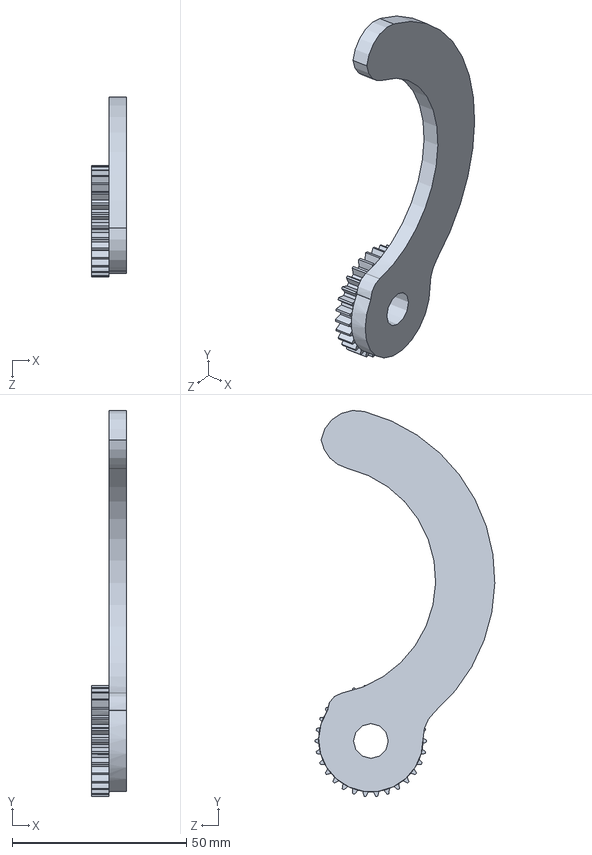
[picture p61: CAD file, 2023-01-13]
CAO_SolidWorks/Pince/engrenage1.SLDPRT
10.0 x 110.8 x 51.6 mm
