alidanda93/RoboBeer/CAO_SolidWorks/roue folle 0.5pouce/bille.SLDPRT

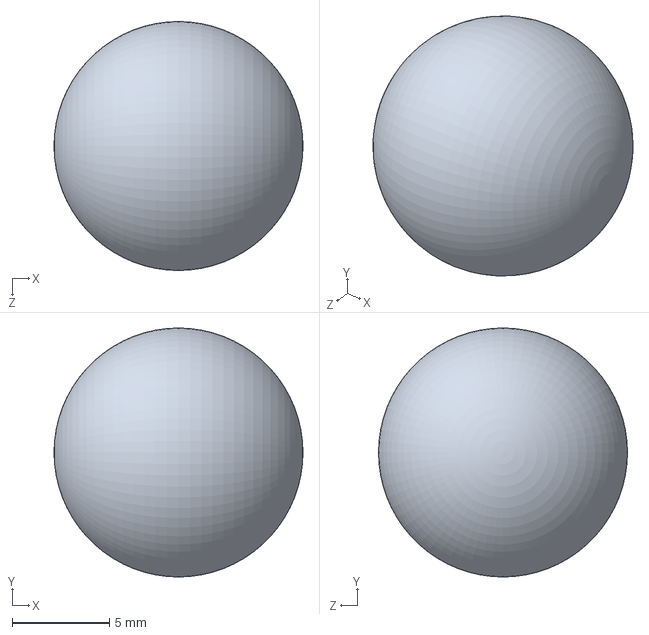
[picture p62: CAD file, 2023-01-13]
CAO_SolidWorks/roue folle 0.5pouce/bille.SLDPRT
12.8 x 12.8 x 12.8 mm
