alidanda93/RoboBeer/CAO_SolidWorks/STL/Base rolante p2.STL

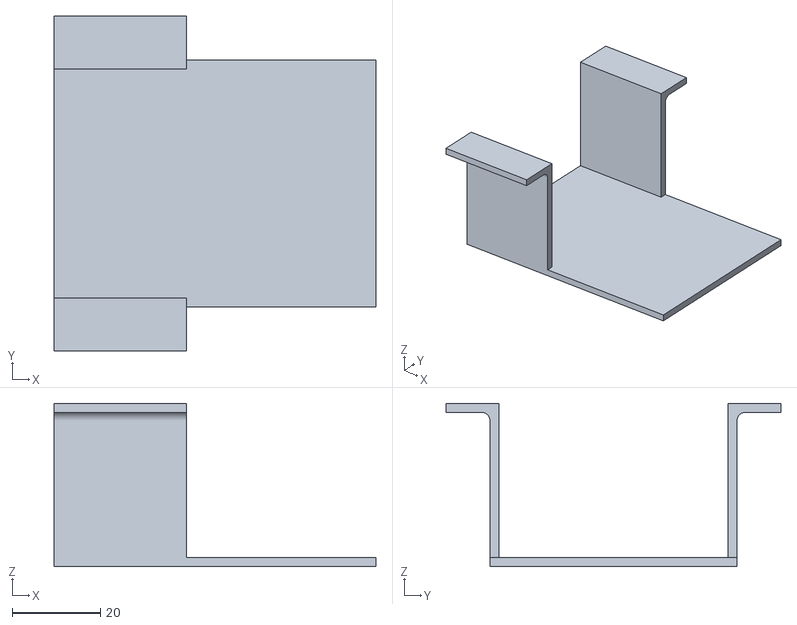
[picture p63: CAD file, 2023-01-13]
CAO_SolidWorks/STL/Base rolante p2.STL
73.0 x 76.0 x 37.0
