alidanda93/RoboBeer/CAO_SolidWorks/Pince/Supportv2_2.SLDPRT

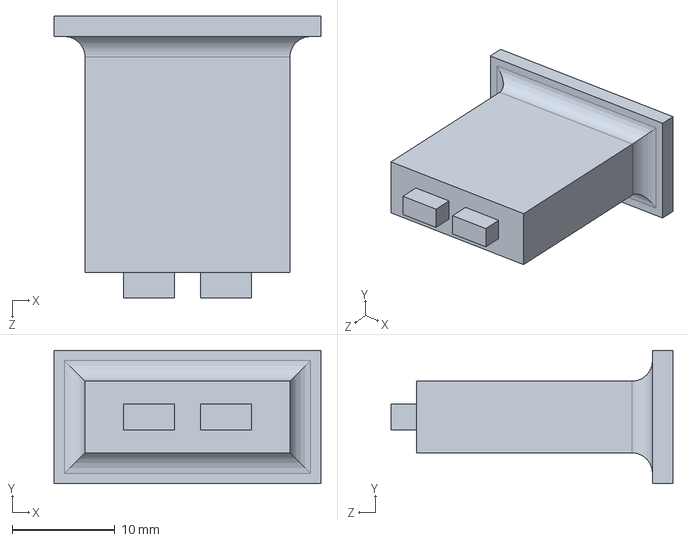
[picture p64: CAD file, 2023-01-13]
CAO_SolidWorks/Pince/Supportv2_2.SLDPRT
26.0 x 13.0 x 27.5 mm
