alidanda93/RoboBeer/CAO_SolidWorks/STL/Base rolante p1.STL

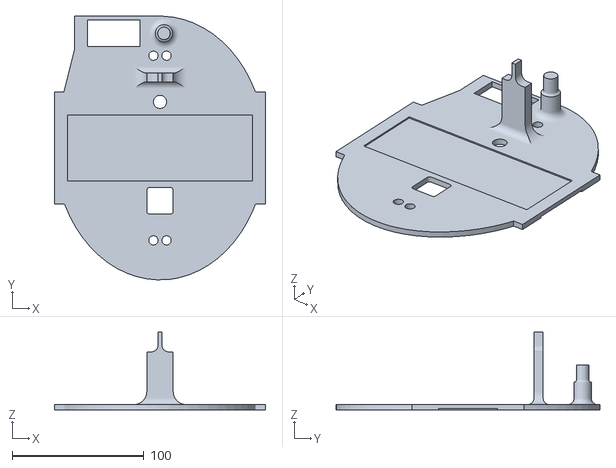
[picture p65: CAD file, 2023-01-13]
CAO_SolidWorks/STL/Base rolante p1.STL
160.0 x 200.0 x 59.0
