alidanda93/RoboBeer/CAO_SolidWorks/SupportCarteMere.SLDPRT

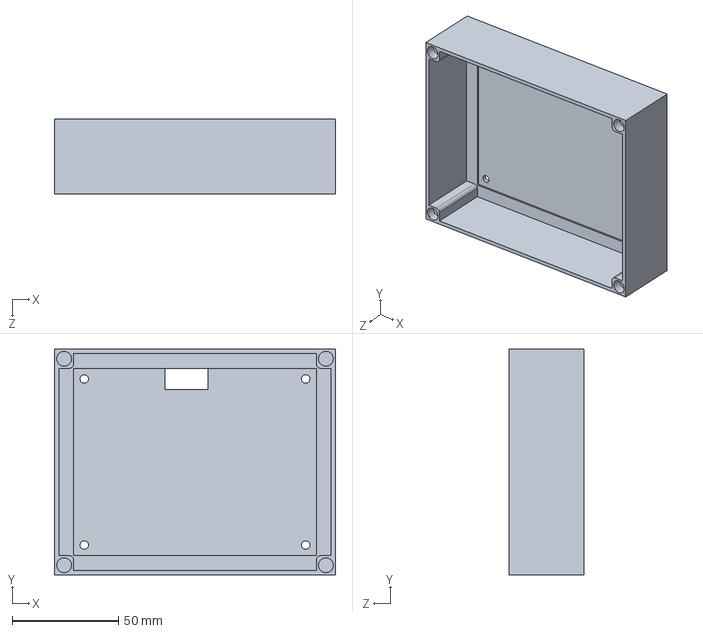
[picture p66: CAD file, 2023-01-16]
CAO_SolidWorks/SupportCarteMere.SLDPRT
132.0 x 106.0 x 35.0 mm
