alidanda93/RoboBeer/CAO_SolidWorks/couvercleCarteMere.SLDPRT

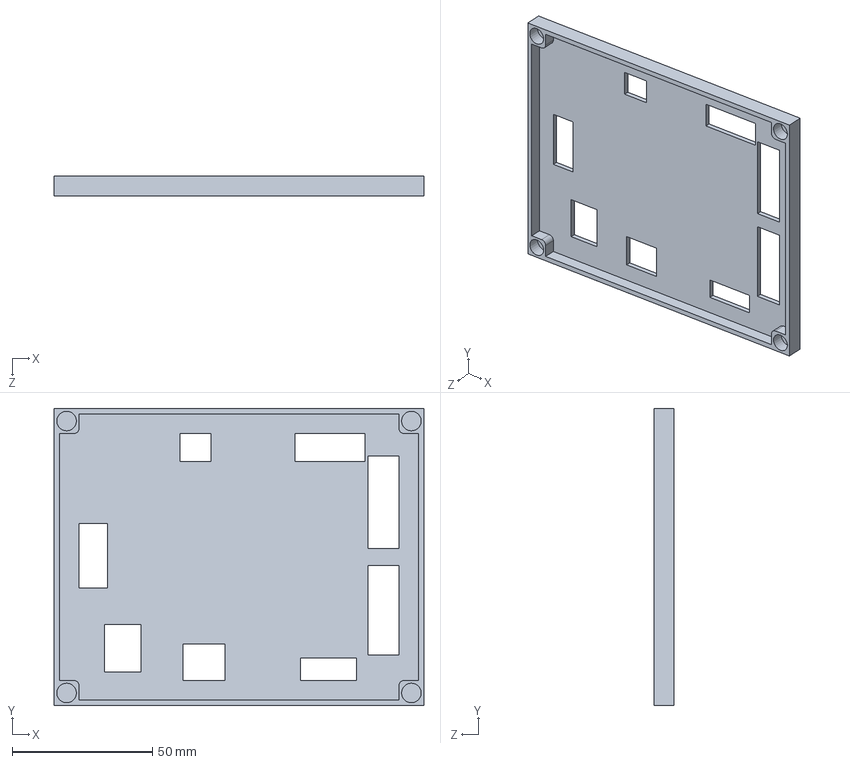
[picture p67: CAD file, 2023-01-16]
CAO_SolidWorks/couvercleCarteMere.SLDPRT
132.0 x 106.0 x 7.00 mm
