alidanda93/RoboBeer/CAO_SolidWorks/Pince/Supportv3_1.STL

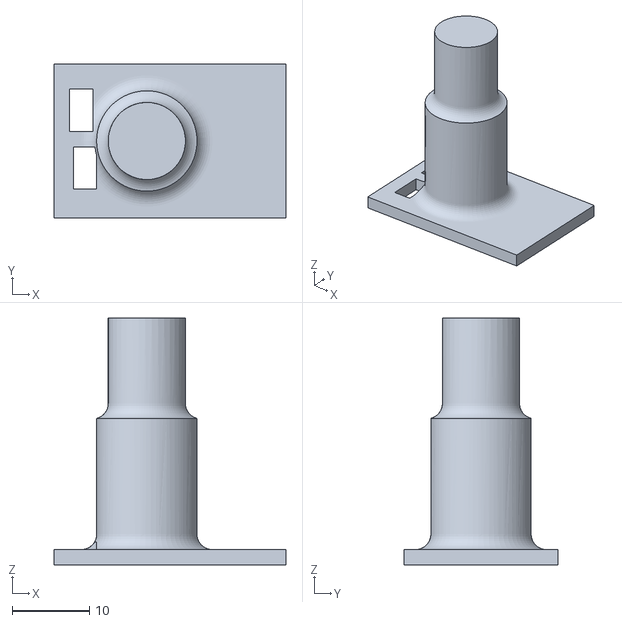
[picture p68: CAD file, 2023-01-13]
CAO_SolidWorks/Pince/Supportv3_1.STL
30.0 x 20.0 x 32.0
