alidanda93/RoboBeer/CAO_SolidWorks/Base rolante part2.SLDPRT

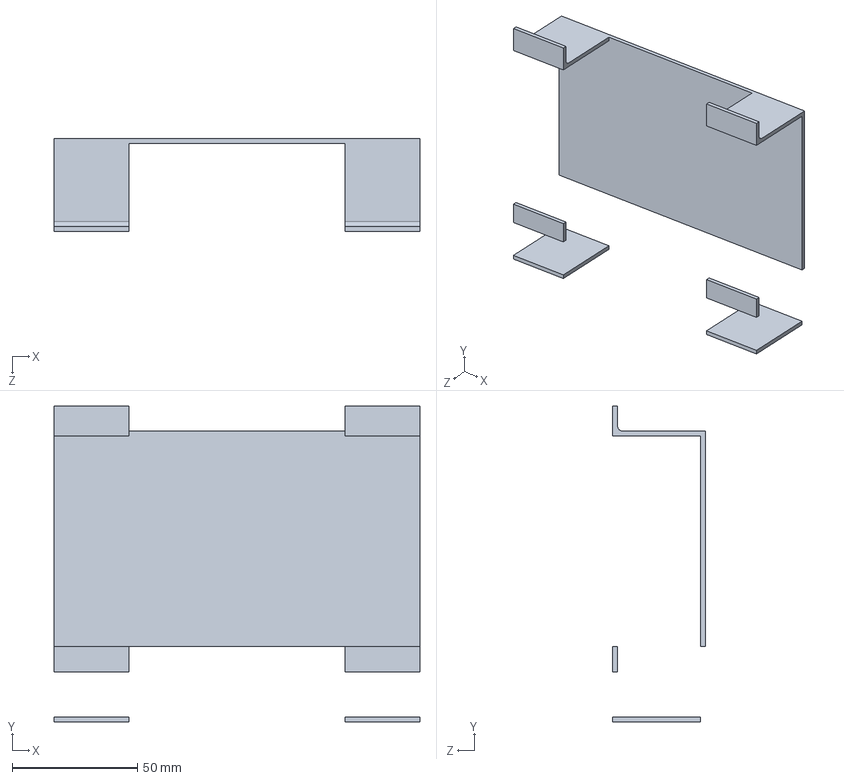
[picture p69: CAD file, 2023-01-13]
CAO_SolidWorks/Base rolante part2.SLDPRT
146.0 x 126.0 x 37.0 mm
