alidanda93/RoboBeer/CAO_SolidWorks/Pince/engrenage2.SLDPRT

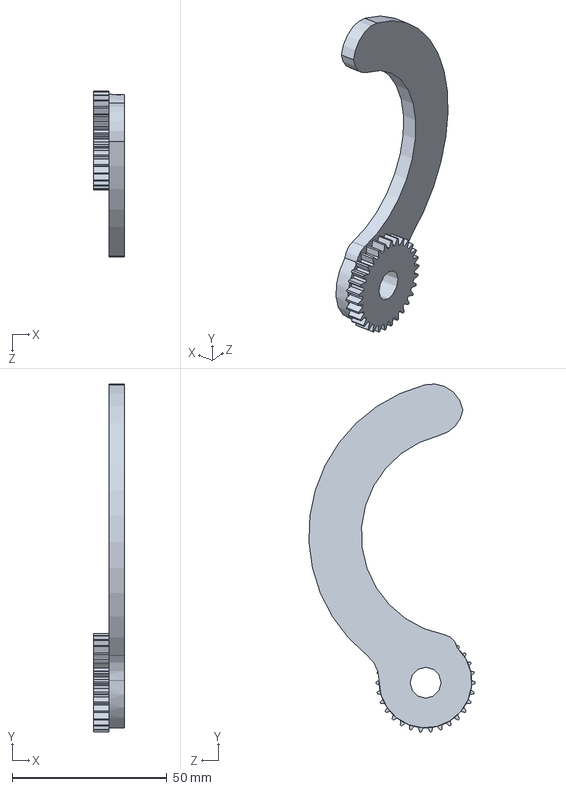
[picture p70: CAD file, 2023-01-13]
CAO_SolidWorks/Pince/engrenage2.SLDPRT
10.0 x 112.6 x 53.8 mm
