alidanda93/RoboBeer/CAO_SolidWorks/Pince/Support Pince.SLDPRT

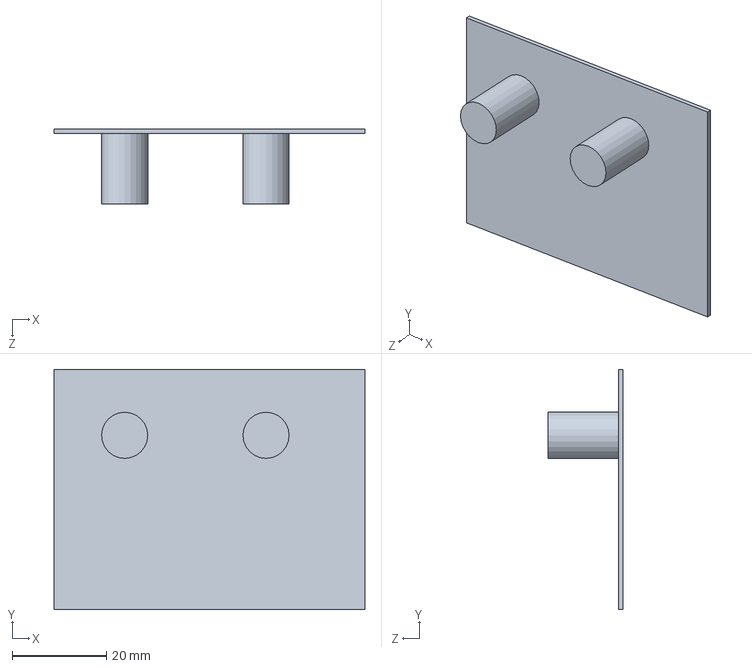
[picture p71: CAD file, 2023-01-13]
CAO_SolidWorks/Pince/Support Pince.SLDPRT
66.0 x 51.0 x 16.0 mm
