alidanda93/RoboBeer/CAO_SolidWorks/TOF.SLDPRT

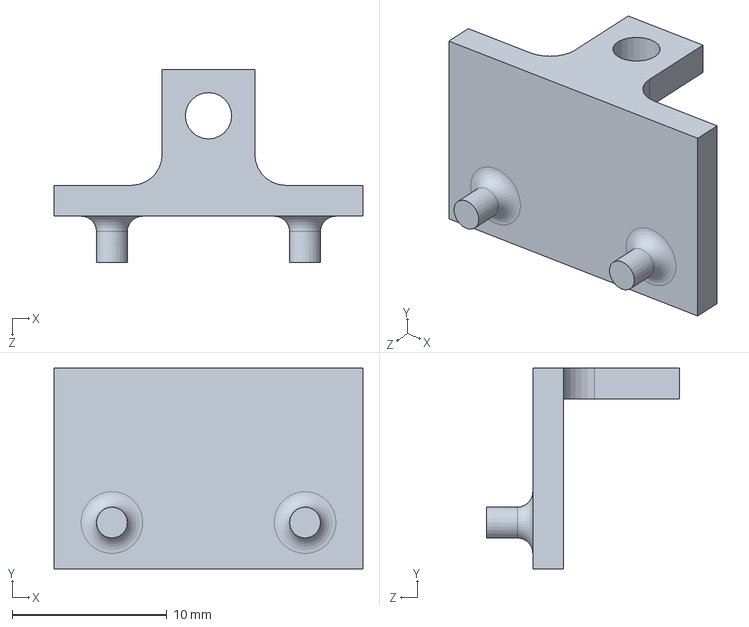
[picture p72: CAD file, 2023-01-13]
CAO_SolidWorks/TOF.SLDPRT
20.0 x 13.0 x 12.5 mm
