alidanda93/RoboBeer/CAO_SolidWorks/rouefolle.SLDPRT

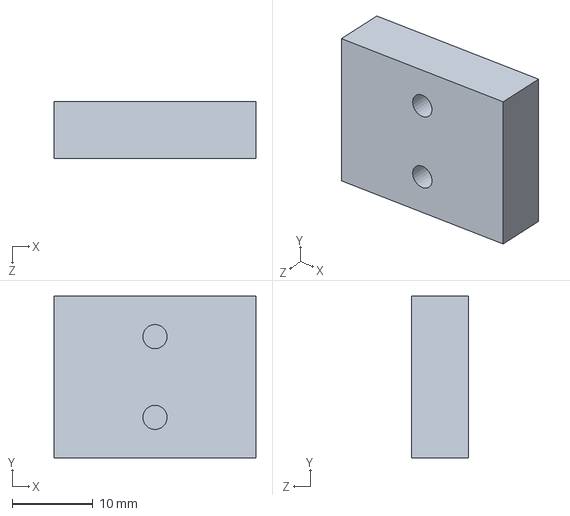
[picture p73: CAD file, 2023-01-13]
CAO_SolidWorks/rouefolle.SLDPRT
25.0 x 20.0 x 7.00 mm
