alidanda93/RoboBeer/CAO_SolidWorks/entretoise.SLDPRT

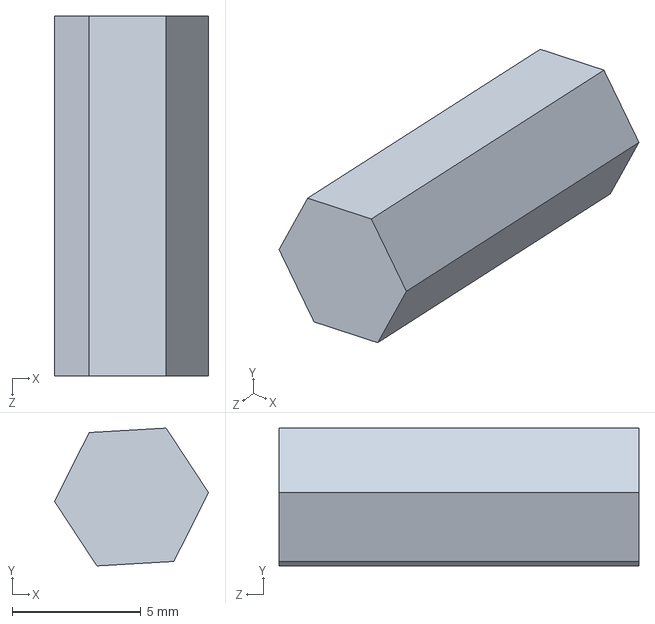
[picture p74: CAD file, 2023-01-13]
CAO_SolidWorks/entretoise.SLDPRT
5.99 x 5.36 x 14.0 mm
