alidanda93/RoboBeer/CAO_SolidWorks/support BDT.SLDPRT

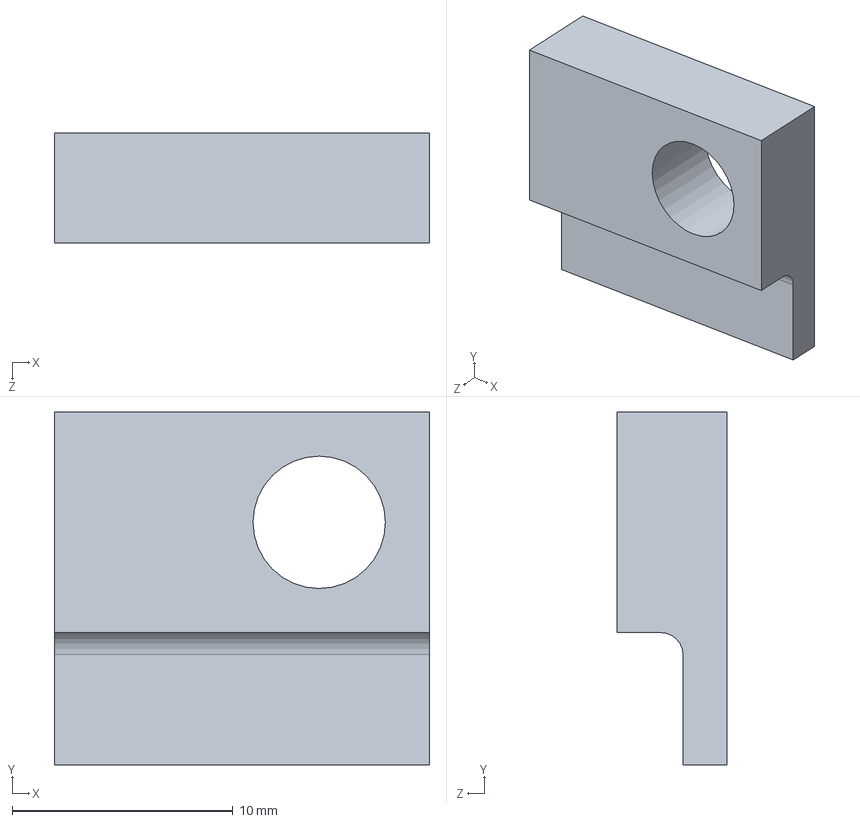
[picture p75: CAD file, 2023-01-13]
CAO_SolidWorks/support BDT.SLDPRT
17.0 x 16.0 x 5.00 mm
