alidanda93/RoboBeer/CAO_SolidWorks/pneu.SLDPRT

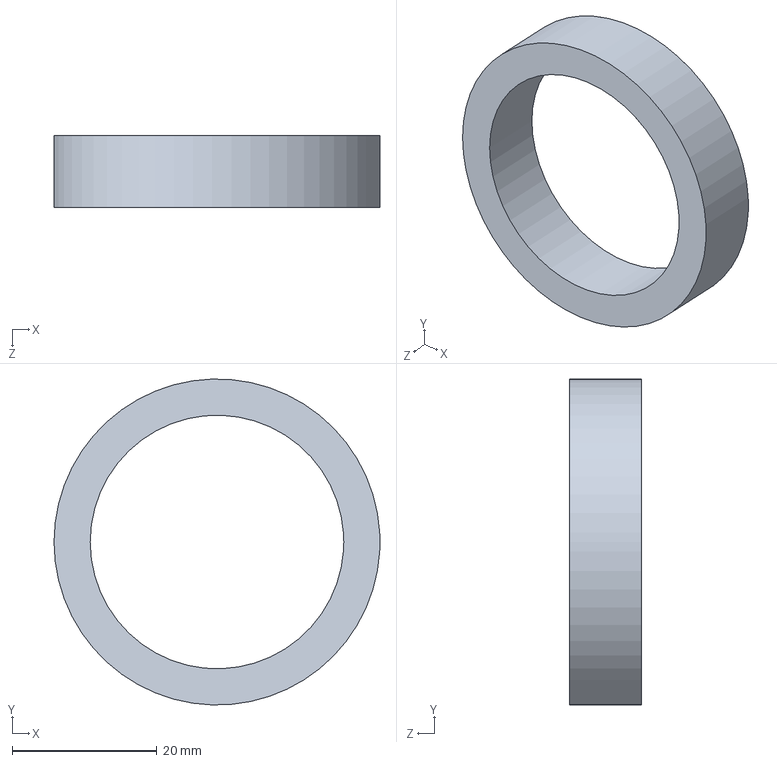
[picture p76: CAD file, 2023-01-13]
CAO_SolidWorks/pneu.SLDPRT
45.0 x 45.0 x 10.0 mm
