alidanda93/RoboBeer/CAO_SolidWorks/roue_part2.SLDPRT

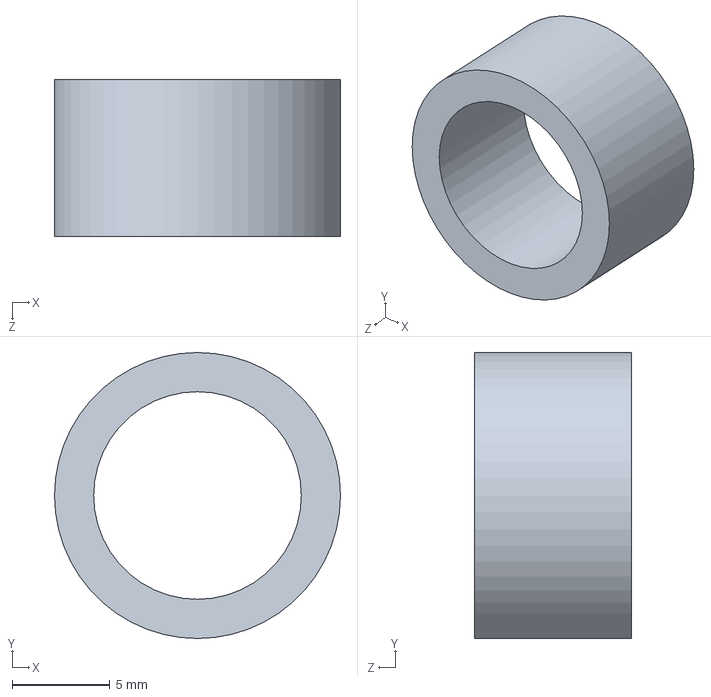
[picture p77: CAD file, 2023-01-13]
CAO_SolidWorks/roue_part2.SLDPRT
14.6 x 14.6 x 8.00 mm
