alidanda93/RoboBeer/CAO_SolidWorks/Base rolante.SLDPRT

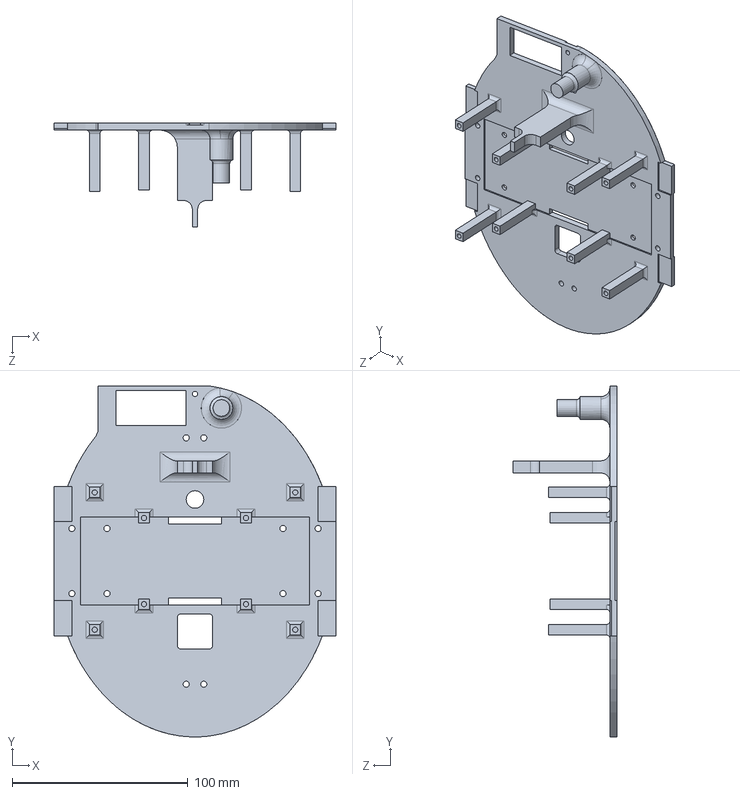
[picture p78: CAD file, 2023-01-13]
CAO_SolidWorks/Base rolante.SLDPRT
160.0 x 199.5 x 59.0 mm
