alidanda93/RoboBeer/CAO_SolidWorks/Immat.SLDPRT

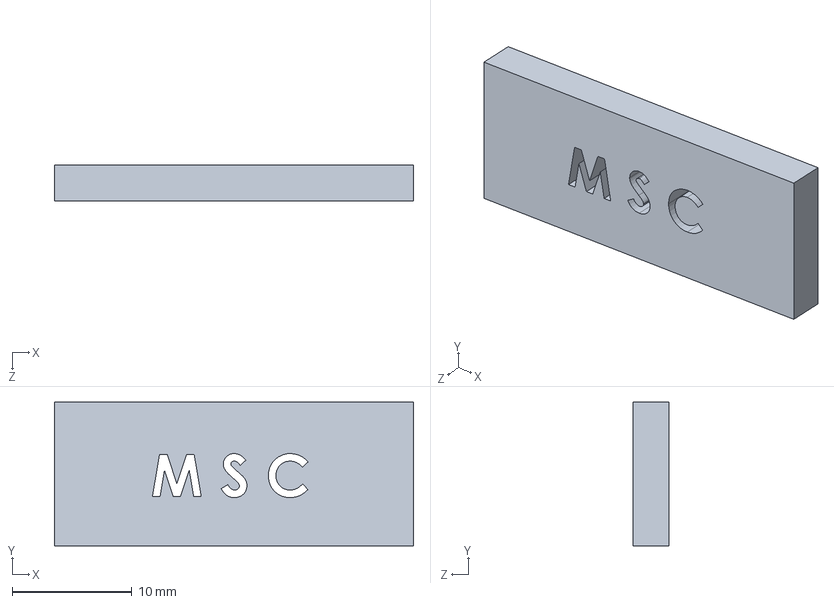
[picture p79: CAD file, 2023-01-13]
CAO_SolidWorks/Immat.SLDPRT
30.0 x 12.0 x 3.00 mm
