alidanda93/RoboBeer/CAO_SolidWorks/roue_v2.SLDPRT

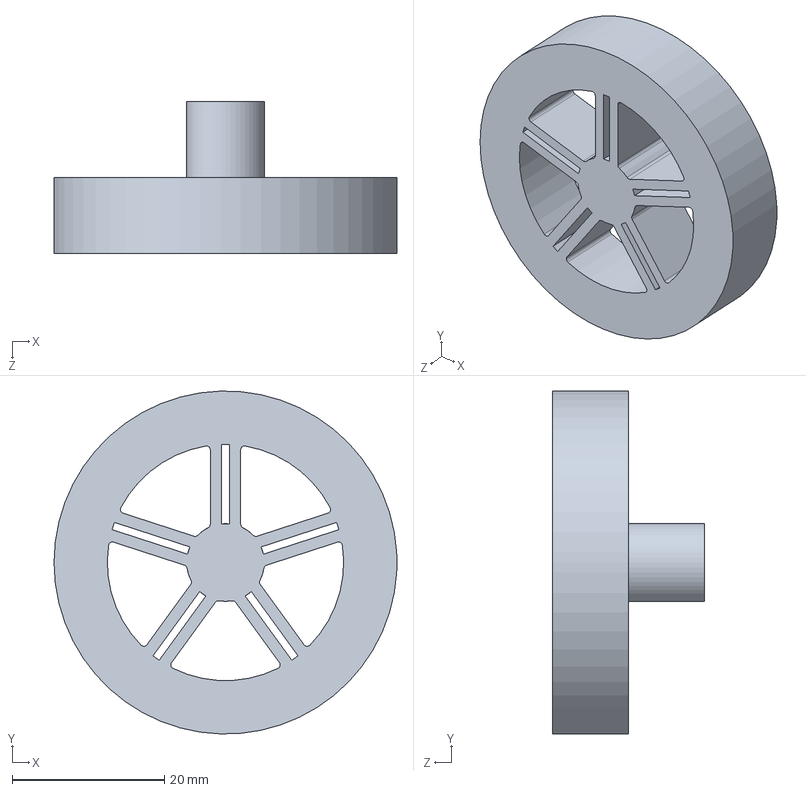
[picture p80: CAD file, 2023-01-13]
CAO_SolidWorks/roue_v2.SLDPRT
45.0 x 45.0 x 20.0 mm
