alidanda93/RoboBeer/(list of files, cad)

Other CAD files:
CAO_SolidWorks/Pince/Supportv4_1.STL
CAO_SolidWorks/Pince/Supportv3_2.STL
CAO_SolidWorks/support_moteur_v2.SLDPRT
CAO_SolidWorks/Old/demi-roue1.SLDPRT
CAO_SolidWorks/Old/demi-roue1.STL
CAO_SolidWorks/Old/demi-roue2.SLDPRT
CAO_SolidWorks/Old/demi-roue2.STL
CAO_SolidWorks/Old/roue_v1.SLDPRT
CAO_SolidWorks/Old/roue_v1.STL
CAO_SolidWorks/Old/support_moteur.SLDPRT
CAO_SolidWorks/Old/support_moteur_v1.SLDPRT
CAO_SolidWorks/Old/support_moteur_v1.STL
CAO_SolidWorks/Old/support_moteur_v2.STL
CAO_SolidWorks/Pince/Supportv2_1.STL
CAO_SolidWorks/Pince/Supportv2_2.STL
CAO_SolidWorks/Pince/engrenage1.STL
CAO_SolidWorks/Pince/engrenage2.STL
CAO_SolidWorks/STL/BDT.STL
CAO_SolidWorks/STL/Base rolante.STL
CAO_SolidWorks/STL/SupportCarteMere.STL
CAO_SolidWorks/STL/TOF.STL
CAO_SolidWorks/STL/couvercleCarteMere.STL
CAO_SolidWorks/STL/pneu.STL
CAO_SolidWorks/STL/roue_part2.STL
CAO_SolidWorks/STL/roue_v2.STL
CAO_SolidWorks/STL/rouefolle.STL
CAO_SolidWorks/STL/support BDT.STL
