alidanda93/RoboBeer/STM32/RoboBeer/Core/Src/main.c

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
/* Includes ------------------------------------------------------------------*/
#include "main.h"
#include "adc.h"
#include "dma.h"
#include "i2c.h"
#include "tim.h"
#include "usart.h"
#include "gpio.h"

/* USER CODE BEGIN Includes */
#include <stdio.h>
#include <stdlib.h>
#include <string.h>
#include "driver_ToF.h"
#include "led.h"
#include "Servo.h"
#include "MCC.h"
#include "PI.h"
#include "shell.h"
#include "Test.h"
#include "Rasp.h"
/* USER CODE END Includes */


/* USER CODE BEGIN PV */

extern uint8_t uartRxReceived;
extern uint8_t uartRxBuffer[UART_RX_BUFFER_SIZE];
extern uint8_t uartTxBuffer[UART_TX_BUFFER_SIZE];

extern uint8_t uartRxReceivedRasp;
extern uint8_t uartRxBufferRasp[UART_RX_BUFFER_SIZE];
extern uint8_t uartTxBufferRasp[UART_TX_BUFFER_SIZE];

//BaseType_t xReturned;
//TaskHandle_t xHandle1 = NULL;
//TaskHandle_t xHandle2 = NULL;
//
///*
// * These are the private variables for the Encoder
// */
//BaseType_t xReturned_Encoder;
//TaskHandle_t xHandle_Encoder = NULL;
//
///*
// * These are the private variables for the TOF
// */
//BaseType_t xReturned_TofGetDistance;
//TaskHandle_t xHandle_TofGetDistance = NULL;


uint16_t servo_angle=0;

uint16_t dist = 0;		//distance parcourue mesuree par les encodeurs

int tickD = 0;
int consigneD = 0;		//consigne de vitesse entre 0 et 200
int tickG = 0;
int consigneG = 0;


int action = 3; 		//mouvement à realiser (avancer tourner reculer stop)
int sens = 0;

int actionRasp = 3;
int sensRasp = 0;
int couleur = 0;
int enable = 0; 		//detection canette par la raspebrry, permet de savoir si on peut utiliser les données transmises
int emergencySTOP = 0;

extern int start;

#define nb_mesure 5
int TOF_tab[nb_mesure];
uint tab_i=0;

int TOF_dist = 0;

int enableUserButton = 0;

PIController MoteurD;
PIController MoteurG;


/* USER CODE END PV */

void SystemClock_Config(void);
/* USER CODE BEGIN PFP */

/*Normal functions*/


/*Task Functions*/
void codeTache (void * pvParameters);
void GetEncoderValue(void * pvParameters);
void TofGetDistance(void * pvParameters);
void RaspRead (void * pvParameters);

/* USER CODE END PFP */

/* USER CODE BEGIN 0 */

/**
 * @brief Fonction qui detecte et affiche sur l'UART1 tous les peripheriques présent sur l'I2C2
 *
 * @param None
 *
 * @retval None
 *
 */
void TestSensorOnI2C(int * tab)
{
	 int u = 0;

	 printf("debut de lecture du bus I2c\r\n\n");
	  for(int i =0; i< 256; i++)
	  {
		  int result = HAL_I2C_IsDeviceReady(&hi2c2, (uint16_t)(i),2,2);
		  if (result != HAL_OK)//HAL_ERROR or HAL_TIMEOUT
		  {
			  printf("."); //No ACKreceived at the address
		  }
		  if (result == HAL_OK)
		  {
			  tab[u] = i;
			  u++;
			  printf("0x%X",i); //Received an ACK at the address
		  }
	  }
	  printf("\r\n\nfin de lecture du bus I2C\r\n\n\n");
}


/* USER CODE END 0 */

/**
  * @brief  The application entry point.
  * @retval int
  */
int main(void)
{
  /* MCU Configuration--------------------------------------------------------*/

  /* Reset of all peripherals, Initializes the Flash interface and the Systick. */
  HAL_Init();

  /* Configure the system clock */
  SystemClock_Config();

  /* Initialize all configured peripherals */
  MX_GPIO_Init();
  MX_DMA_Init();
  MX_TIM3_Init();
  MX_USART1_UART_Init();
  MX_USART2_UART_Init();
  MX_TIM1_Init();
  MX_TIM2_Init();
  MX_TIM5_Init();
  MX_ADC1_Init();
  MX_TIM7_Init();
  MX_TIM6_Init();
  MX_TIM4_Init();
  MX_I2C2_Init();
  /* USER CODE BEGIN 2 */



  HAL_UART_Receive_IT(&huart1, uartRxBuffer, UART_RX_BUFFER_SIZE);
  HAL_Delay(1);
  shellInit();

  HAL_UART_Receive_DMA(&huart2, uartRxBufferRasp, UART_RX_BUFFER_SIZE_RASP);

  //HAL_UART_Receive_IT(&huart2, uartRxBufferRasp, UART_RX_BUFFER_SIZE_RASP);
  //HAL_Delay(1);

  int tabI2CAdd[8] = {0,0,0,0,0,0,0,0};
  TestSensorOnI2C(tabI2CAdd);
  initTof();
  //int tabI2CAdd[8] = {0,0,0,0,0,0,0,0};
  //TestSensorOnI2C(tabI2CAdd);

  TurnOffLed(1);
  TurnOffLed(2);
  TurnOffLed(3);
  TurnOffLed(4);

  HAL_TIM_Base_Start_IT(&htim3);
  HAL_TIM_PWM_Start_IT(&htim3, TIM_CHANNEL_1);
  ControlServo(SERVO_CLOSED);

  HAL_TIM_Base_Start_IT(&htim6);
  InitMCC();

  HAL_TIM_Encoder_Start(&htim2, TIM_CHANNEL_ALL);
  HAL_TIM_Encoder_Start(&htim5, TIM_CHANNEL_ALL);

  PIController_Init(&MoteurD);
  PIController_Init(&MoteurG);

  HAL_TIM_Base_Start_IT(&htim7); //interrupt chaque second pour print les données dans le shell
  HAL_TIM_Base_Start_IT(&htim4);

  /* USER CODE END 2 */

  /* Infinite loop */
  /* USER CODE BEGIN WHILE */
  while (1)
  {
    /* USER CODE END WHILE */

    /* USER CODE BEGIN 3 */
	  if(start)
	  {
		  //Test_Rasp();
		  Test_Canette();
		  //Test_Tourner();
		  //Test_Odometrie_Carre();
	  }
	  //printf("start\r\n");



  }
  /* USER CODE END 3 */
}

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
/* USER CODE BEGIN 4 */
int __io_putchar(int ch) {
	HAL_UART_Transmit(&huart1, (uint8_t *)&ch, 1, HAL_MAX_DELAY);
	return ch;
}

void HAL_TIM_PeriodElapsedCallback(TIM_HandleTypeDef *htim)
{
	if (htim->Instance == TIM3) // 50Hz freq lecture TOF
	{


	}



	else if (htim->Instance == TIM7) //Tim 7 1sec pour du printf shell
	{
		//printf("%d\r\n", dist);
		printf("distance : %d\r\n", TOF_dist);
	}
	else if (htim->Instance == TIM4) //Delay Tof
		{
			TOF_tab[tab_i] = tofReadDistance();
			tab_i = (tab_i+1)%nb_mesure;
			if(tab_i==10000) tab_i = 0;
			int d_moy = 0;
			for(int i=0; i<nb_mesure; i++)
			{
				d_moy += TOF_tab[i];
			}
			TOF_dist = d_moy/nb_mesure;

			//printf("distance : %d\r\n", TOF_dist);
		}

	else if (htim->Instance == TIM6) //Tim 6 asserv en vitesse a 0.1sec
		{

		if(emergencySTOP)
			{
			action = STOP;
			HAL_TIM_PWM_Stop(&htim1, TIM_CHANNEL_ALL);
			//Error_Handler();
			}
		else
		{
			switch(action)
			{
			case TOURNER :
				if(sens)dist -=	(( (TIM2->CNT)-Mid_Period_TIM2 ) + ((TIM5->CNT) - Mid_Period_TIM5 ) ) / 2; //on moyenne la valeur
				else dist +=	(( (TIM2->CNT)-Mid_Period_TIM2 ) + ((TIM5->CNT) - Mid_Period_TIM5 ) ) / 2; //on moyenne la valeur
				break;
			default :
				dist +=	(( (TIM2->CNT)-Mid_Period_TIM2 ) + ( Mid_Period_TIM5 - (TIM5->CNT)) ) / 2; //on moyenne la valeur
				break;
			}

			  ReadEncodeur();

			  if(consigneD == 0)
			  {
				  Stop();
			  }

			  else
			  {
				switch(action)
				{
				case AVANCER :
					PIController_Update(&MoteurD, consigneD, tickD * MAX_ARR / OmaxD);
					PIController_Update(&MoteurG, consigneG, tickG * MAX_ARR / OmaxG);
					AvancerPI(0, MoteurD.out);
					AvancerPI(1, MoteurG.out);
					break;

				case RECULER :
					PIController_Update(&MoteurD, consigneD, tickD * MAX_ARR / OmaxD);
					PIController_Update(&MoteurG, consigneG, tickG * MAX_ARR / OmaxG);
					ReculerPI(0, MoteurD.out);
					ReculerPI(1, MoteurG.out);
					break;

				case TOURNER :
					PIController_Update(&MoteurD, consigneD, tickD * MAX_ARR / OmaxD);
					PIController_Update(&MoteurG, consigneG, tickG * MAX_ARR / OmaxG);
					if(sens)
					{
						ReculerPI(0, MoteurD.out);
						AvancerPI(1, MoteurG.out);
					}
					else
					{
						AvancerPI(0, MoteurD.out);
						ReculerPI(1, MoteurG.out);
					}
					break;

				default :
					Stop();
					break;
				}

			  }
			}
		}
}

void HAL_GPIO_EXTI_Callback(uint16_t GPIO_Pin)  // <----- The ISR Function We're Looking For!
{
	//enableUserButton = (enableUserButton+1) % 2; //passe 0 à 1 et 1 à 0
	if(GPIO_Pin == USER_BTN_Pin)
	{
		Debut_Test();
	}
	else if (GPIO_Pin == BDT1_Pin || GPIO_Pin == BDT2_Pin || GPIO_Pin == BDT3_Pin || GPIO_Pin == BDT4_Pin)
	{
		SwitchLed(2);
		//emergencySTOP = 1;
	}

}

/**
  * @brief  Function called at each new character received
  * @retval None
  */
void HAL_UART_RxCpltCallback (UART_HandleTypeDef * huart)
{
	if(huart->Instance == USART1)
	{
		HAL_UART_Receive_IT(&huart1, uartRxBuffer, UART_RX_BUFFER_SIZE);
		if(shellGetChar())
		{
		  shellExec();
		  shellPrompt();
		}
	}
	else if(huart->Instance == USART2)
	{
		HAL_UART_Receive_DMA(&huart2, uartRxBufferRasp, UART_RX_BUFFER_SIZE_RASP);
		raspGetChar();
		raspExec();
	}

}
/* USER CODE END 4 */
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
