alidanda93/RoboBeer/STM32/RoboBeer/Core/Inc/main.h

#define USER_BTN_Pin GPIO_PIN_13
#define USER_BTN_GPIO_Port GPIOC
#define USER_BTN_EXTI_IRQn EXTI15_10_IRQn
#define MOTOR_2_ENCODER_A_Pin GPIO_PIN_0
#define MOTOR_2_ENCODER_A_GPIO_Port GPIOA
#define MOTOR_2_ENCODER_B_Pin GPIO_PIN_1
#define MOTOR_2_ENCODER_B_GPIO_Port GPIOA
#define RASP_USART2_TX_Pin GPIO_PIN_2
#define RASP_USART2_TX_GPIO_Port GPIOA
#define RASP_USART2_RX_Pin GPIO_PIN_3
#define RASP_USART2_RX_GPIO_Port GPIOA
#define MOTOR_1_ADC1_CURRENT_SENSOR_Pin GPIO_PIN_4
#define MOTOR_1_ADC1_CURRENT_SENSOR_GPIO_Port GPIOA
#define MOTOR_2_ADC1_CURRENT_SENSOR_Pin GPIO_PIN_5
#define MOTOR_2_ADC1_CURRENT_SENSOR_GPIO_Port GPIOA
#define BDT1_Pin GPIO_PIN_6
#define BDT1_GPIO_Port GPIOA
#define BDT1_EXTI_IRQn EXTI9_5_IRQn
#define BDT2_Pin GPIO_PIN_7
#define BDT2_GPIO_Port GPIOA
#define BDT2_EXTI_IRQn EXTI9_5_IRQn
#define BDT3_Pin GPIO_PIN_0
#define BDT3_GPIO_Port GPIOB
#define BDT3_EXTI_IRQn EXTI0_IRQn
#define BDT4_Pin GPIO_PIN_1
#define BDT4_GPIO_Port GPIOB
#define BDT4_EXTI_IRQn EXTI1_IRQn
#define TOF_SCL_Pin GPIO_PIN_10
#define TOF_SCL_GPIO_Port GPIOB
#define TOF_SDA_Pin GPIO_PIN_11
#define TOF_SDA_GPIO_Port GPIOB
#define LED_1_Pin GPIO_PIN_12
#define LED_1_GPIO_Port GPIOB
#define LED_2_Pin GPIO_PIN_13
#define LED_2_GPIO_Port GPIOB
#define LED_3_Pin GPIO_PIN_14
#define LED_3_GPIO_Port GPIOB
#define LED_4_Pin GPIO_PIN_15
#define LED_4_GPIO_Port GPIOB
#define PINCE_PWM_Pin GPIO_PIN_6
#define PINCE_PWM_GPIO_Port GPIOC
#define MOTOR_2_PWM_IN2_Pin GPIO_PIN_8
#define MOTOR_2_PWM_IN2_GPIO_Port GPIOA
#define MOTOR_2_PWM_IN1_Pin GPIO_PIN_9
#define MOTOR_2_PWM_IN1_GPIO_Port GPIOA
#define MOTOR_1_PWM_IN2_Pin GPIO_PIN_10
#define MOTOR_1_PWM_IN2_GPIO_Port GPIOA
#define MOTOR_1_PWM_IN1_Pin GPIO_PIN_11
#define MOTOR_1_PWM_IN1_GPIO_Port GPIOA
#define MOTOR_1_ENCODER_A_Pin GPIO_PIN_15
#define MOTOR_1_ENCODER_A_GPIO_Port GPIOA
#define MOTOR_1_ENCODER_B_Pin GPIO_PIN_3
#define MOTOR_1_ENCODER_B_GPIO_Port GPIOB
#define TOF_Interrupt_Pin GPIO_PIN_4
#define TOF_Interrupt_GPIO_Port GPIOB
#define TOF_Interrupt_EXTI_IRQn EXTI4_IRQn
#define TOF_XSHUT_Pin GPIO_PIN_5
#define TOF_XSHUT_GPIO_Port GPIOB
#define STLINK_USART1_TX_Pin GPIO_PIN_6
#define STLINK_USART1_TX_GPIO_Port GPIOB
#define STLINK_USART1_RX_Pin GPIO_PIN_7
#define STLINK_USART1_RX_GPIO_Port GPIOB
#define STACK_SIZE 1000
#define MAX_S_Time 300
#define DELAY_1 10
#define DELAY_2 10
#define DELAY_3 50
#define DELAY_4 20
#define Code_Priority 2
#define PRIORITY_ENCODER 5
#define PRIORITY_TOF 7
#define PRIORITY_RASP 3
#define PRIORITY_SERVO 1
#define RASP_UART_TO 300
