alidanda93/RoboBeer/STM32/RoboBeer/Core/Inc/driver_ToF.h

#ifndef INC_DRIVER_TOF_H_
#define INC_DRIVER_TOF_H_





//
// Copyright (c) 2017 Larry Bank
// email: bitbank@pobox.com
//
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
#include "stm32f1xx_hal.h"
#include "main.h"
#define ToF_Device_Address 0x52
extern I2C_HandleTypeDef hi2c2;

//
// Read the model and revision of the
// tof sensor
//
int tofGetModel(int *model, int *revision);

//
// Read the current distance in mm
//
int tofReadDistance(void);

//
// Opens a file system handle to the I2C device
// sets the device continous capture mode
//
int tofInit(int bLongRange);


/*
 * driver_ToF.h
 *
 *  Created on: Nov 23, 2022
 *      Author: ludov
 */


int initTof(void);
int TofShutdown(void);
void RB_Delay(int);

#endif /* INC_DRIVER_TOF_H_ */
