alidanda93/RoboBeer/STM32/RoboBeer/Core/Inc/led.h

/*
 * led.h
 *
 *  Created on: Jan 12, 2023
 *      Author: quent
 */

#ifndef INC_LED_H_
#define INC_LED_H_


#include "main.h"


void TurnOnLed(int i);
void TurnOffLed(int i);
void SwitchLed(int i);
void LedError();




#endif /* INC_LED_H_ */
