alidanda93/RoboBeer/STM32/RoboBeer/Core/Src/Test.c

/**
  ******************************************************************************
  * @file           : Test.c
  * @brief          : lib uses to give action command for the robobeer
  * @author 		: quenphil42
  ******************************************************************************
  */

/*
 * Test.c
 *
 *  Created on: Jan 16, 2023
 *      Author: quent
 */


#include "MCC.h"
#include "servo.h"
#include "Test.h"

extern int dist;

extern int tickD;
extern int consigneD;
extern int tickG;
extern int consigneG;
extern int action; 		//mouvement à realiser (avancer tourner reculer stop)
extern int sens;

extern int TOF_dist;

int start = 0;

#define DIST 3000
#define DELAY 1000
#define OFFSET_OUVERTURE_PINCE 90
#define TOF_DEVANT_CANNETTE_VALUE 250
#define TOF_SEUIL 1000


/**
 * @brief Fonction qui initialiser les variables mémoires pour l'odométrie et change l'etat de la variable start
 *
 * @param None
 *
 * @retval None
 *
 */
void Debut_Test()
{
	start = (start+1)%2;
	dist = 0;
}


/**
 * @brief Fonction bloquante qui permet de faire deplacer le robot en une trajectoire carrée
 *
 * @param None
 *
 * @retval None
 *
 */
void Test_Odometrie_Carre()
{
	/* avancer 1*/

	consigneD = 200;	//vitesse
	consigneG = 200;	//vitesse
	action = AVANCER;
	while(dist < DIST)
	{

	}
	action =  STOP;
	dist = 0;
	HAL_Delay(DELAY);



	/* tourner gauche */

	action = TOURNER;
	while(dist < TOUR/4)
	{
	}
	action =  STOP;
	dist = 0;
	HAL_Delay(DELAY);

	/* avancer 2 */

	action = AVANCER;
	dist = 0;
	while(dist < DIST)
	{

	}
	action =  STOP;
	dist = 0;
	HAL_Delay(DELAY);

	/* tourner gauche */

	action = TOURNER;
	while(dist < TOUR/4)
	{
	}
	action =  STOP;
	dist = 0;
	HAL_Delay(DELAY);

	/*	avancer 3 */

	action = AVANCER;
	dist = 0;
	while(dist < DIST)
	{

	}
	action =  STOP;
	dist = 0;
	HAL_Delay(DELAY);


	/* tourner gauche */

	action = TOURNER;
	while(dist < TOUR/4)
	{
	}
	action =  STOP;
	dist = 0;
	HAL_Delay(DELAY);


	/* avancer 4 */


	action = AVANCER;
	dist = 0;
	while(dist < DIST)
	{

	}
	action =  STOP;
	dist = 0;
	HAL_Delay(DELAY);

	/* tourner gauche */

	action = TOURNER;
	while(dist < TOUR/4)
	{
	}
	action =  STOP;
	dist = 0;
	HAL_Delay(DELAY);


	//fin du carre
	/* ouvrir + fermer pince */
	ControlServo(SERVO_OPEN);
	HAL_Delay(2000);
	ControlServo(SERVO_CLOSED);
	HAL_Delay(2000);
}

/**
 * @brief Fonction bloquante qui permet de faire tourner le robot sur lui même un tour
 *
 * @param None
 *
 * @retval None
 *
 */
void Test_Tourner()
{
	consigneD = 200;	//vitesse
	consigneG = 200;	//vitesse
	action = TOURNER;
	while(dist < TOUR)
	{
	}
	action =  STOP;
	dist = 0;
	/*ControlServo(SERVO_OPEN);
	HAL_Delay(2000);
	ControlServo(SERVO_CLOSED);*/
	HAL_Delay(2000);
}



/*Avant test Attention :
 * verifier que TOF_dist est MAJ souvent (mettre dans Tim3)
 * verifier valeur TOF_dist quand rien n'est detecte (est ce 0 ou Max Val ?)
 */

/**
 * @brief Fonction bloquante qui permet de detecter une canette s'en approcher, la saisir et la redeposer devant le point de départ du robot.
 *
 * @param None
 *
 * @retval None
 *
 */
void Test_Canette()
{

	int angle = 0;
	int dist_cannette = 0;

	/* Init - ouverture fermeture des pinces */
	ControlServo(SERVO_OPEN);
	HAL_Delay(DELAY);
	ControlServo(SERVO_CLOSED);
	HAL_Delay(DELAY);


	/* Detection canette - rotation + lecture TOF + stockage angle */
	consigneD = 200;	//vitesse
	consigneG = 200;	//vitesse
	action = TOURNER;
	dist = 0;
	while( (TOF_dist > TOF_SEUIL) && (dist < TOUR)) //seuil de detection à TOF_SEUIL mm
	{
	}
	action =  STOP;
	HAL_Delay(DELAY);
	if(dist > TOUR) Error_Handler(); 	//Systeme en default cannette non vue
	angle = dist; 						//on memorise la valeur de l'angle parcouru


	/* Avancer tout droit + mesure distance jusqu'à TOF = 0*/
	action =  AVANCER;
	dist = 0;
	/*while(dist < dist_cannette - OFFSET_OUVERTURE_PINCE)
	{
	}*/
	while(TOF_dist > TOF_DEVANT_CANNETTE_VALUE) //tant qu'on est pas face a la canette
	{
	}
	action =  STOP;
	dist_cannette = dist;
	dist = 0;
	HAL_Delay(DELAY);

	/* Ouvrir PINCE + Avancer tout droit OFFSET MESURE TOF */

	ControlServo(SERVO_OPEN);
	HAL_Delay(DELAY);

	action =  AVANCER;
	dist = 0;
	while(dist < OFFSET_OUVERTURE_PINCE )
	{
	}
	action =  STOP;
	dist = 0;
	HAL_Delay(DELAY);


	/* Fermer Pince + Rotation demi tour*/

	ControlServo(SERVO_CLOSED);
	HAL_Delay(DELAY);
	action = TOURNER;
	while(dist < TOUR/2)
	{
	}
	action =  STOP;
	dist = 0;
	HAL_Delay(DELAY);

	/* Avancer valeur dist mesuree */

	action =  AVANCER;
	dist = 0;
	while(dist < dist_cannette+OFFSET_OUVERTURE_PINCE)
	{
	}
	action =  STOP;
	dist = 0;
	HAL_Delay(DELAY);


	/* Tourner (- angle) et avancer OFFSET 10cm*/

	sens = 1;
	action = TOURNER;
	while(dist < angle)
	{
	}
	action =  STOP;
	dist = 0;
	HAL_Delay(DELAY);

	action =  AVANCER;
	dist = 0;
	while(dist < OFFSET_OUVERTURE_PINCE)
	{
	}
	action =  STOP;
	dist = 0;
	HAL_Delay(DELAY);

	/* ouvrir pince + Reculer OFFSET 10cm*/

	ControlServo(SERVO_OPEN);
	HAL_Delay(DELAY);

	action =  RECULER;
	dist = 0;
	while(dist < OFFSET_OUVERTURE_PINCE)
	{
	}
	action =  STOP;
	dist = 0;
	HAL_Delay(DELAY);

	/* Demi Tour*/

	sens = 0;
	action = TOURNER;
	dist = 0;
	while(dist < TOUR/2)
	{
	}
	action =  STOP;
	dist = 0;
	HAL_Delay(DELAY);


	/* Fin Service */

	ControlServo(SERVO_OPEN);
	HAL_Delay(DELAY);
	ControlServo(SERVO_CLOSED);
	HAL_Delay(DELAY);

	while(1){}

}

/**
 * @brief Fonction bloquante non codée pour le moment
 *
 * @param None
 *
 * @retval None
 *
 */
void Test_Rasp()
{

}
