alidanda93/RoboBeer/STM32/RoboBeer/Core/Inc/Test.h

/*
 * Test.h
 *
 *  Created on: Jan 16, 2023
 *      Author: quent
 */

#ifndef INC_TEST_H_
#define INC_TEST_H_

#include "main.h"

void Debut_Test();
void Test_Odometrie_Carre();
void Test_Tourner();
void Test_Canette();
void Test_Rasp();

#endif /* INC_TEST_H_ */
