alidanda93/RoboBeer/(commit log)

2022-10-24 stream camera video feed to client via wifi
2022-11-23 Mise à jour GitHub
    [Color_Sensor.kicad_sch]
2022-12-07 V1.0
    Updated RoboBeer_OS to use tasks
    Updated Files Hierarchy
    [Color_Sensor.kicad_sch]
2022-12-09 Update OS
    TOF task controls Servo Motor
    UART connexion with rpi
2022-12-09 add PCB couleur + carte mere
    [Alim3.3.kicad_sch, Batterie.kicad_sch, Buck_Raspberry.kicad_sch, Buck_STM.kicad_sch, Capteurs.kicad_sch, CarteMereRobobeer.dsn, CarteMereRobobeer.kicad_pcb, CarteMereRobobeer.kicad_sch]
2022-12-09 add Kicad librairies
2022-12-14 V1.1
    Model upload with can data and XML annotations
    [Color_Sensor.kicad_sch]
2022-12-14 updated KiCAD
    Motherboard
    [CarteMereRobobeer.kicad_pcb]
2023-01-08 Image data with annotations & video stream retransmission
    [Color_Sensor.kicad_sch]
2023-01-12 modif Kicad
2023-01-13 update 13/01
    Ajout des fichiers SolidWorks et Début d'harmonisation et création des fonctions de test du PCB.
    LED ok
    UserButton OK
    ServoMoteur OK
    UART_STLINK OK
    J'ai inversé les noms de broches des UART du au cablage Hard de la carte,
    ainsi :
    UART1 <- STLINK
    UART2 <- RASP
    J'ai crée des fichiers pour des librairies LED et SERVO afin de réorganiser le code
    [Alim3.3.kicad_sch, Assemblage.SLDASM, Assemblage1.SLDASM, Assemblage_Base_roulante.SLDASM, Back.stl, Base rolante p1.STL, Base rolante p2.STL, Base rolante part2.SLDPRT]
2023-01-14 update servomoteur
2023-01-15 add encoder + mcc ok
2023-01-16 asservissement OK + debut test odo
    [AssemblageBoitierCarteMere.SLDASM, SupportCarteMere.SLDPRT, SupportCarteMere.STL, couvercleCarteMere.SLDPRT, couvercleCarteMere.STL]
2023-01-16 adaptation test sans OS
    J'ai enlevé tout les flags d'interruption afin de ne laisser la boucle while qu'aux fonctions de tests (qui sont bloquantes)
2023-01-17 test tof + fonction recherche cannette
    J'ai essayé de lire les valeurs du TOF sans succes pour le moment, ca fait planter le shell (sans doute on reste bloquer dans les fonctions de lecture et on ne sort jamais de l'interruption)
    J'ai prepare la fonction de recherche et prehension de la cannette afin qu'elle soit operationnelle des que le TOF fonctionnera.
    [Test.c, Test.h, main.c]
2023-01-17 TOF OK + TEST RASPBERRY READ
2023-01-17 test 1 rasp uart
2023-01-19 update CAO + robobeer (add UART DMA read + TOF Read in test function)
    [BDT.SLDPRT, BDT.STL, roue_part2.STL]
2023-01-20 fixed UART DMA + ADD BDT
    [Rasp.c, Rasp.h, RoboBeer.ioc, Test.c, Test.h, main.c]
2023-01-24 Robobeer based on interrupts
    [Alim3.3.kicad_sch, Batterie.kicad_sch, Buck_Raspberry.kicad_sch, Buck_STM.kicad_sch, Capteurs.kicad_sch, CarteMereRobobeer.dsn, CarteMereRobobeer.kicad_pcb, CarteMereRobobeer.kicad_sch]
