alidanda93/RoboBeer/(notices)

Notices in the files:
STM32/RoboBeer/RoboBeer-main/STM32/RoboBeer/Core/Inc/driver_ToF.h:
This program is free software: you can redistribute it and/or modify
it under the terms of the GNU General Public License as published by
the Free Software Foundation, either version 3 of the License, or
(at your option) any later version.
